majsterkowanieinietylko/EPROMINT/Documentation/CPU_architecture.png

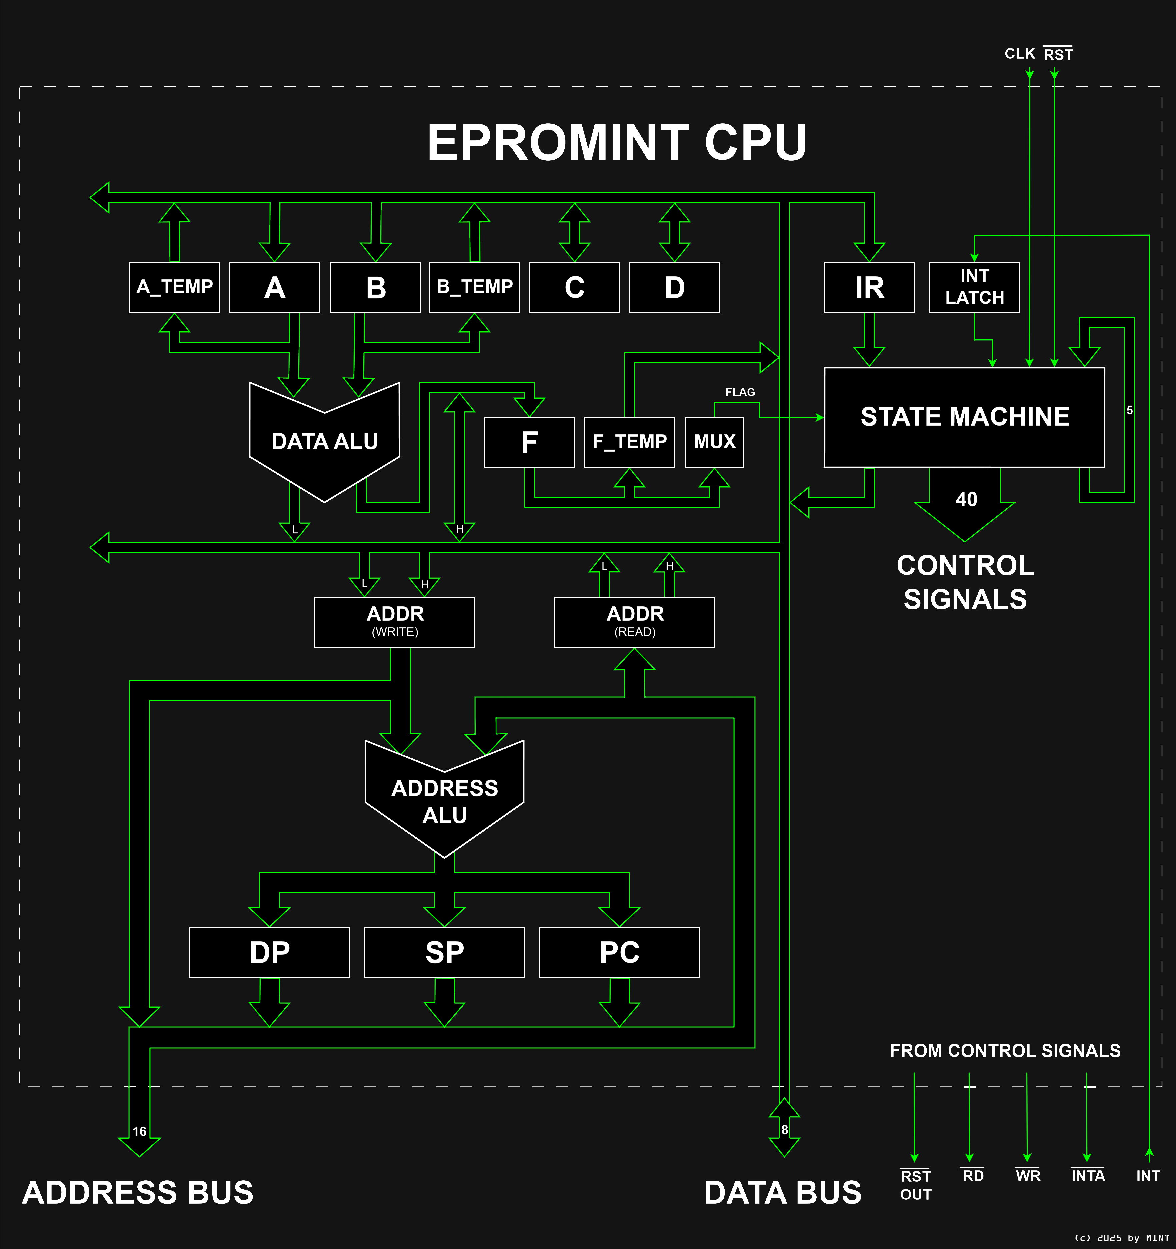
Documentation/CPU_architecture.png
