majsterkowanieinietylko/EPROMINT/Memory_Map_Generator/bg.png

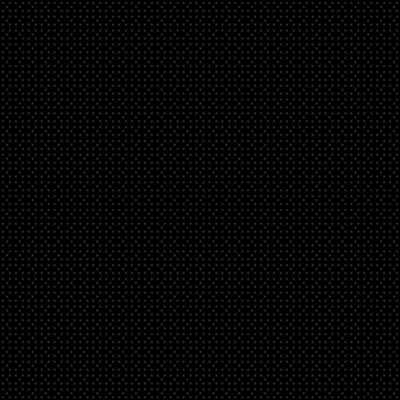
Memory_Map_Generator/bg.png
