majsterkowanieinietylko/EPROMINT/Memory_Map_Generator/ic.jpg

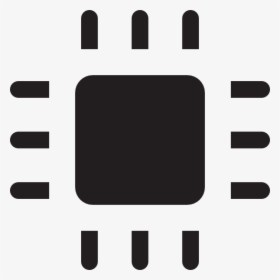
Memory_Map_Generator/ic.jpg
