majsterkowanieinietylko/EPROMINT/CPU_Programs/Bitmap_print/graphic_print.txt

41
EC 04 21
1A 09
19 0A
02
EC 0E 21
E8 20
EC 0F 21
E9 20
EC 08 21
1A 0B
19 0C
02
35
0D 00
0E 01
0F 00

EE 20
4B
D9 FB
50 01
A9 08
D7 F5

49
E6
