majsterkowanieinietylko/EPROMINT/Numeric_display/Schematic/Numeric_display.pdf

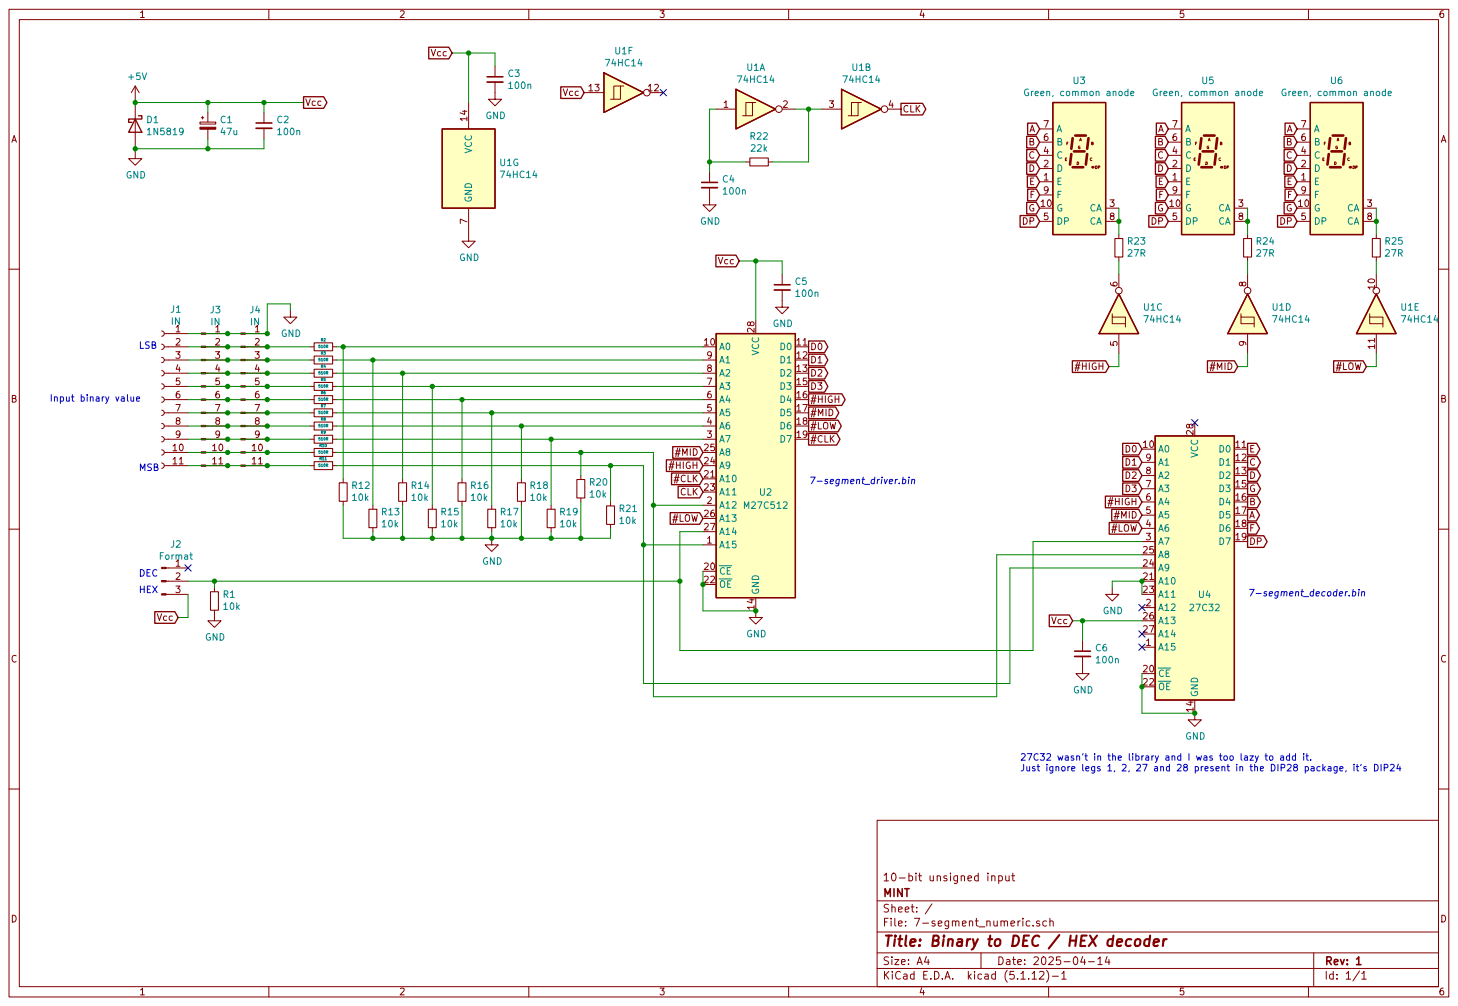
[picture p6: page 1]

27C32 wasn't in the library and I was too lazy to add it.
Just ignore legs 1, 2, 27 and 28 present in the DIP28 package, it's DIP24

10-bit unsigned input
File: 7-segment_numeric.sch Sheet: / MINT

Id: 1/1 Title: Binary to DEC / HEX decoder
