majsterkowanieinietylko/EPROMINT/Sequencer_board/Schematic/Sequencer_board.pdf

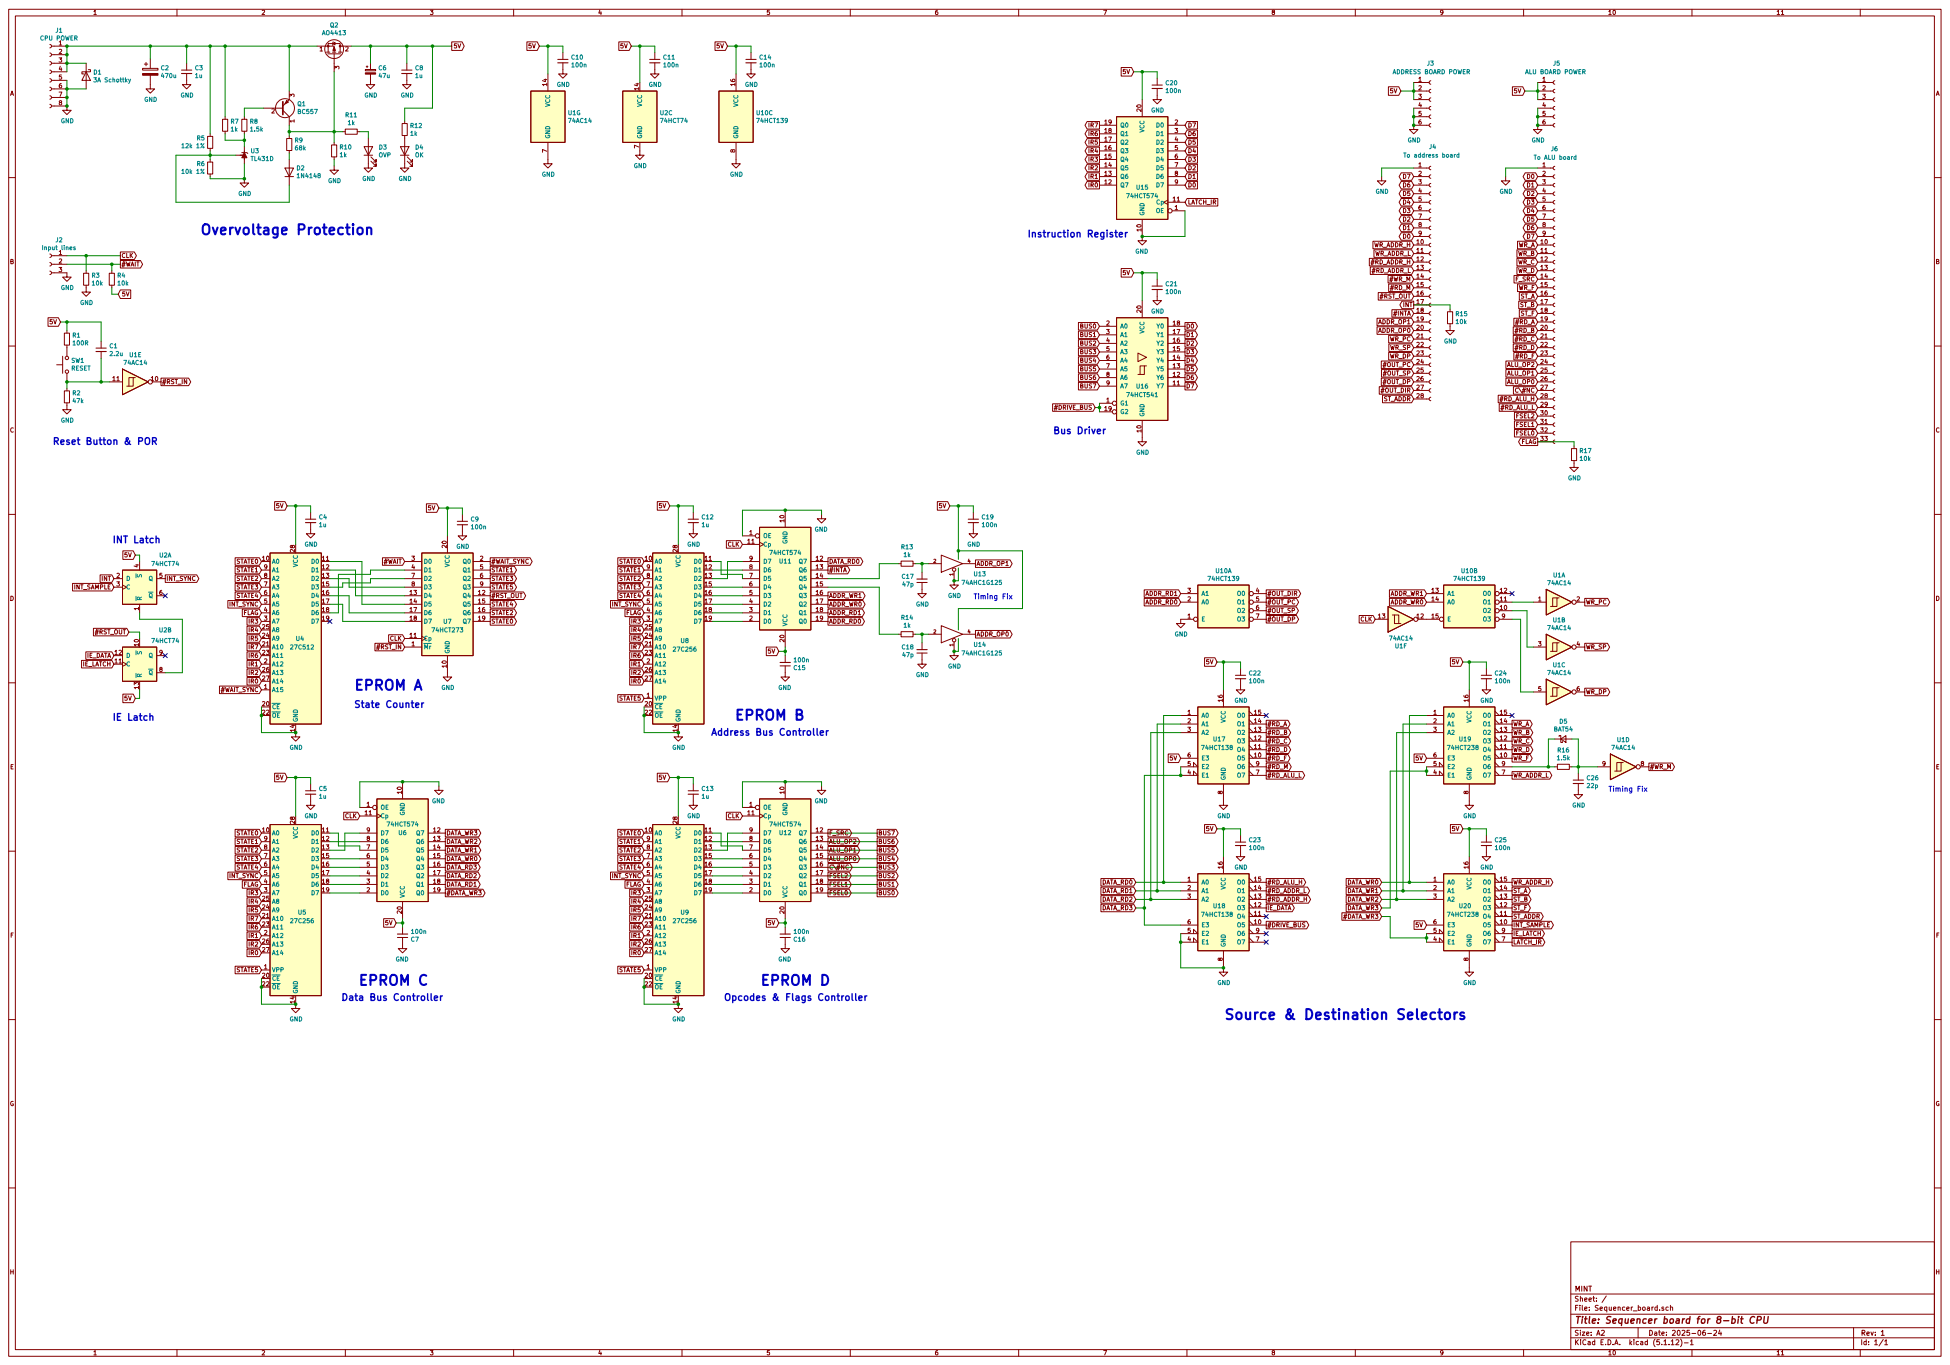
[picture p7: page 1]

J4 To address board VCC 14 GND

File: Sequencer_board.sch Sheet: / MINT

Id: 1/1 Title: Sequencer board for 8-bit CPU
