majsterkowanieinietylko/EPROMINT/ALU_board/Schematic/ALU_board.pdf

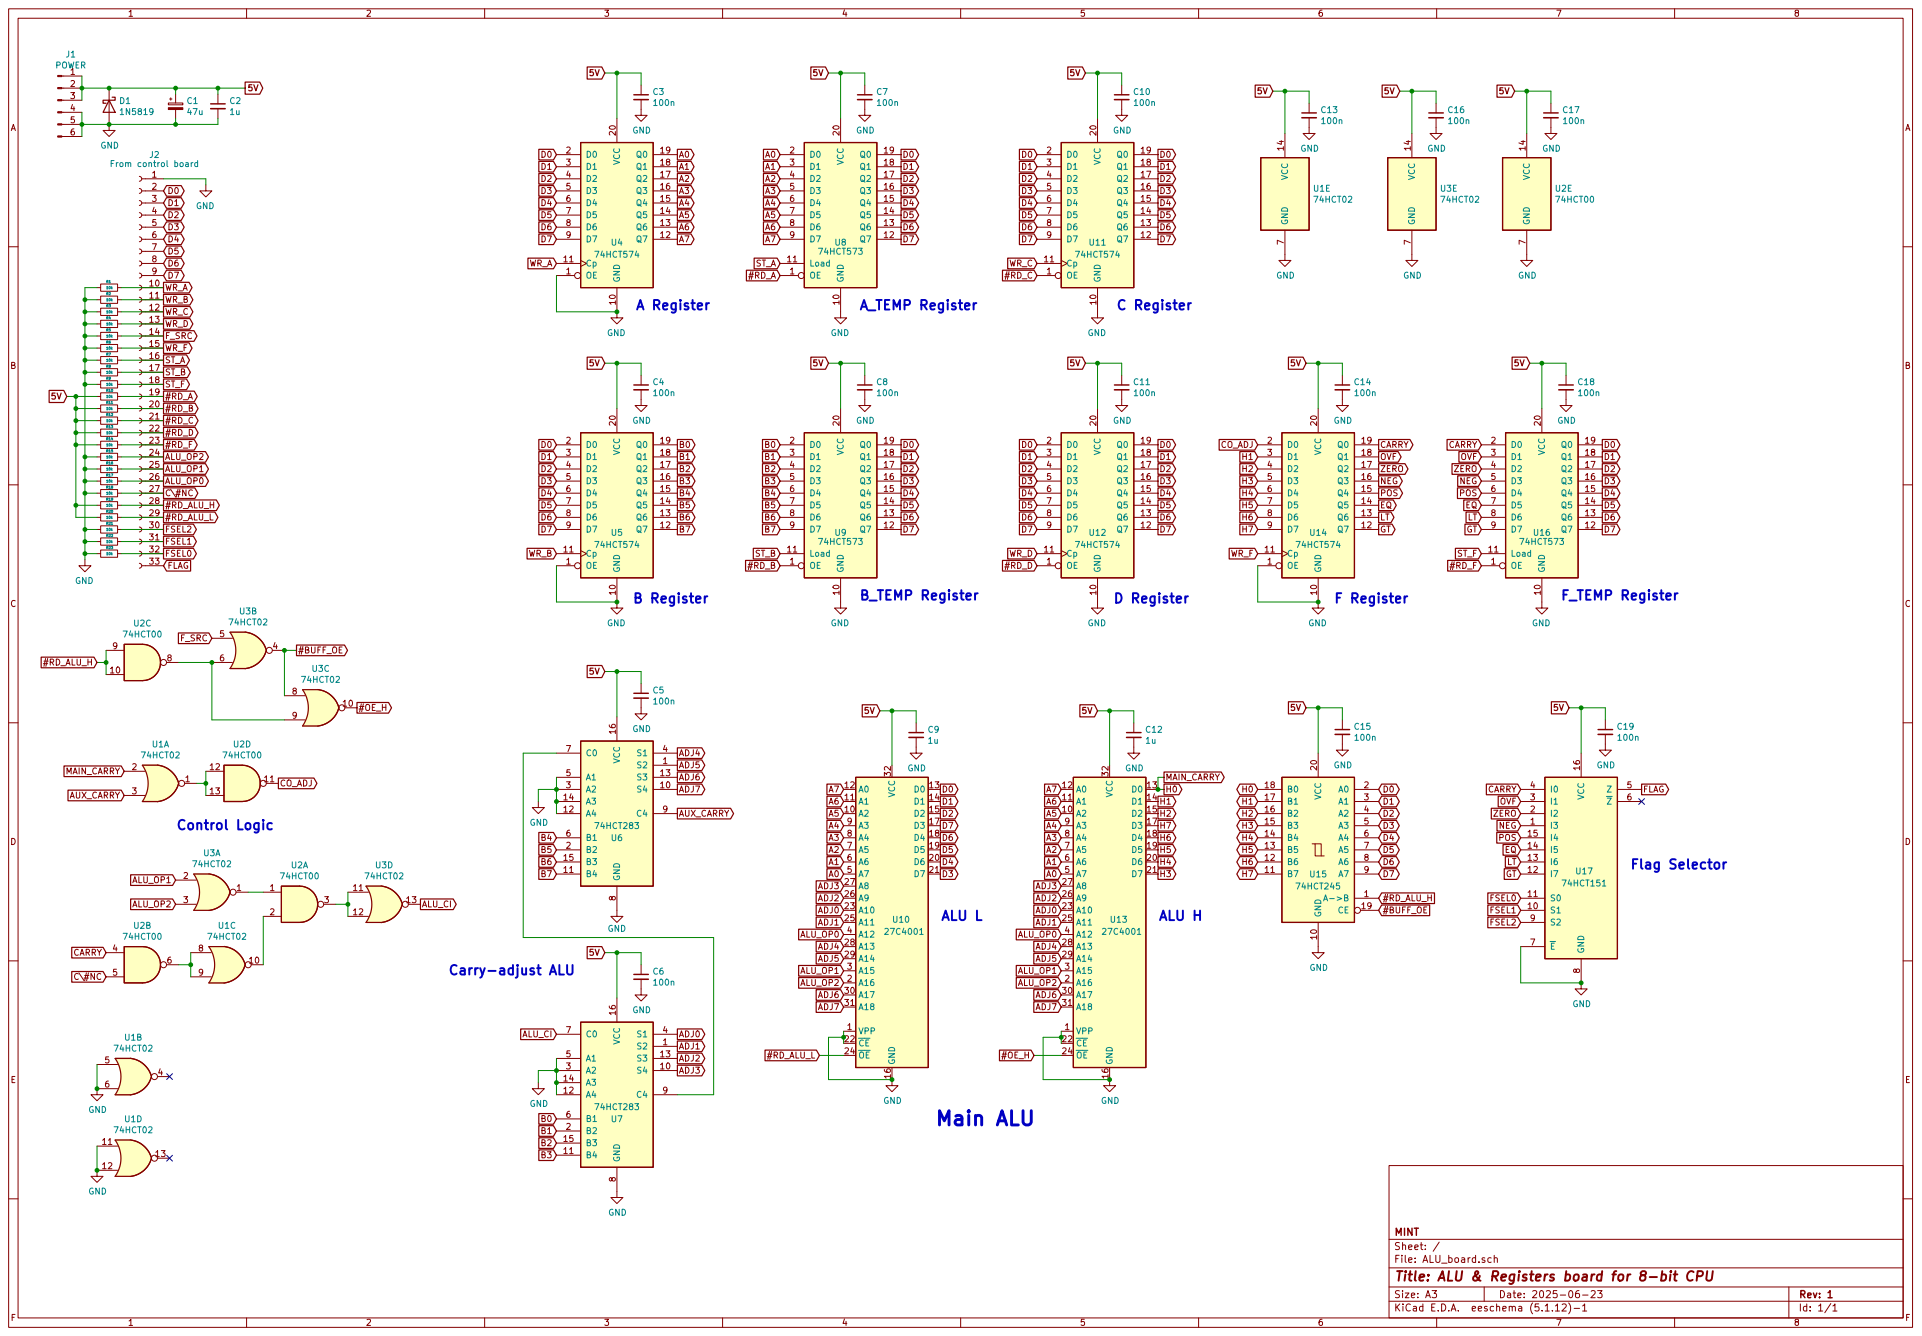
[picture p8: page 1]

File: ALU_board.sch Sheet: / MINT GND

Id: 1/1 Title: ALU & Registers board for 8-bit CPU
