majsterkowanieinietylko/EPROMINT/Documentation/EPROMINT_CPU_all.pdf

# GND GND

68k D2


J4 To address board VCC ¹⁴ GND

File: Sequencer_board.sch Sheet: / MINT

Id: 1/1 Title: Sequencer board for 8-bit CPU

# 100n GND OE 1 GND 10

# 74HCT573GND


File: ALU_board.sch Sheet: / MINT GND

Id: 1/1 Title: ALU & Registers board for 8-bit CPU

74HCT273 Mr 1 | GND 10
100n GND OE 1 | GND 10

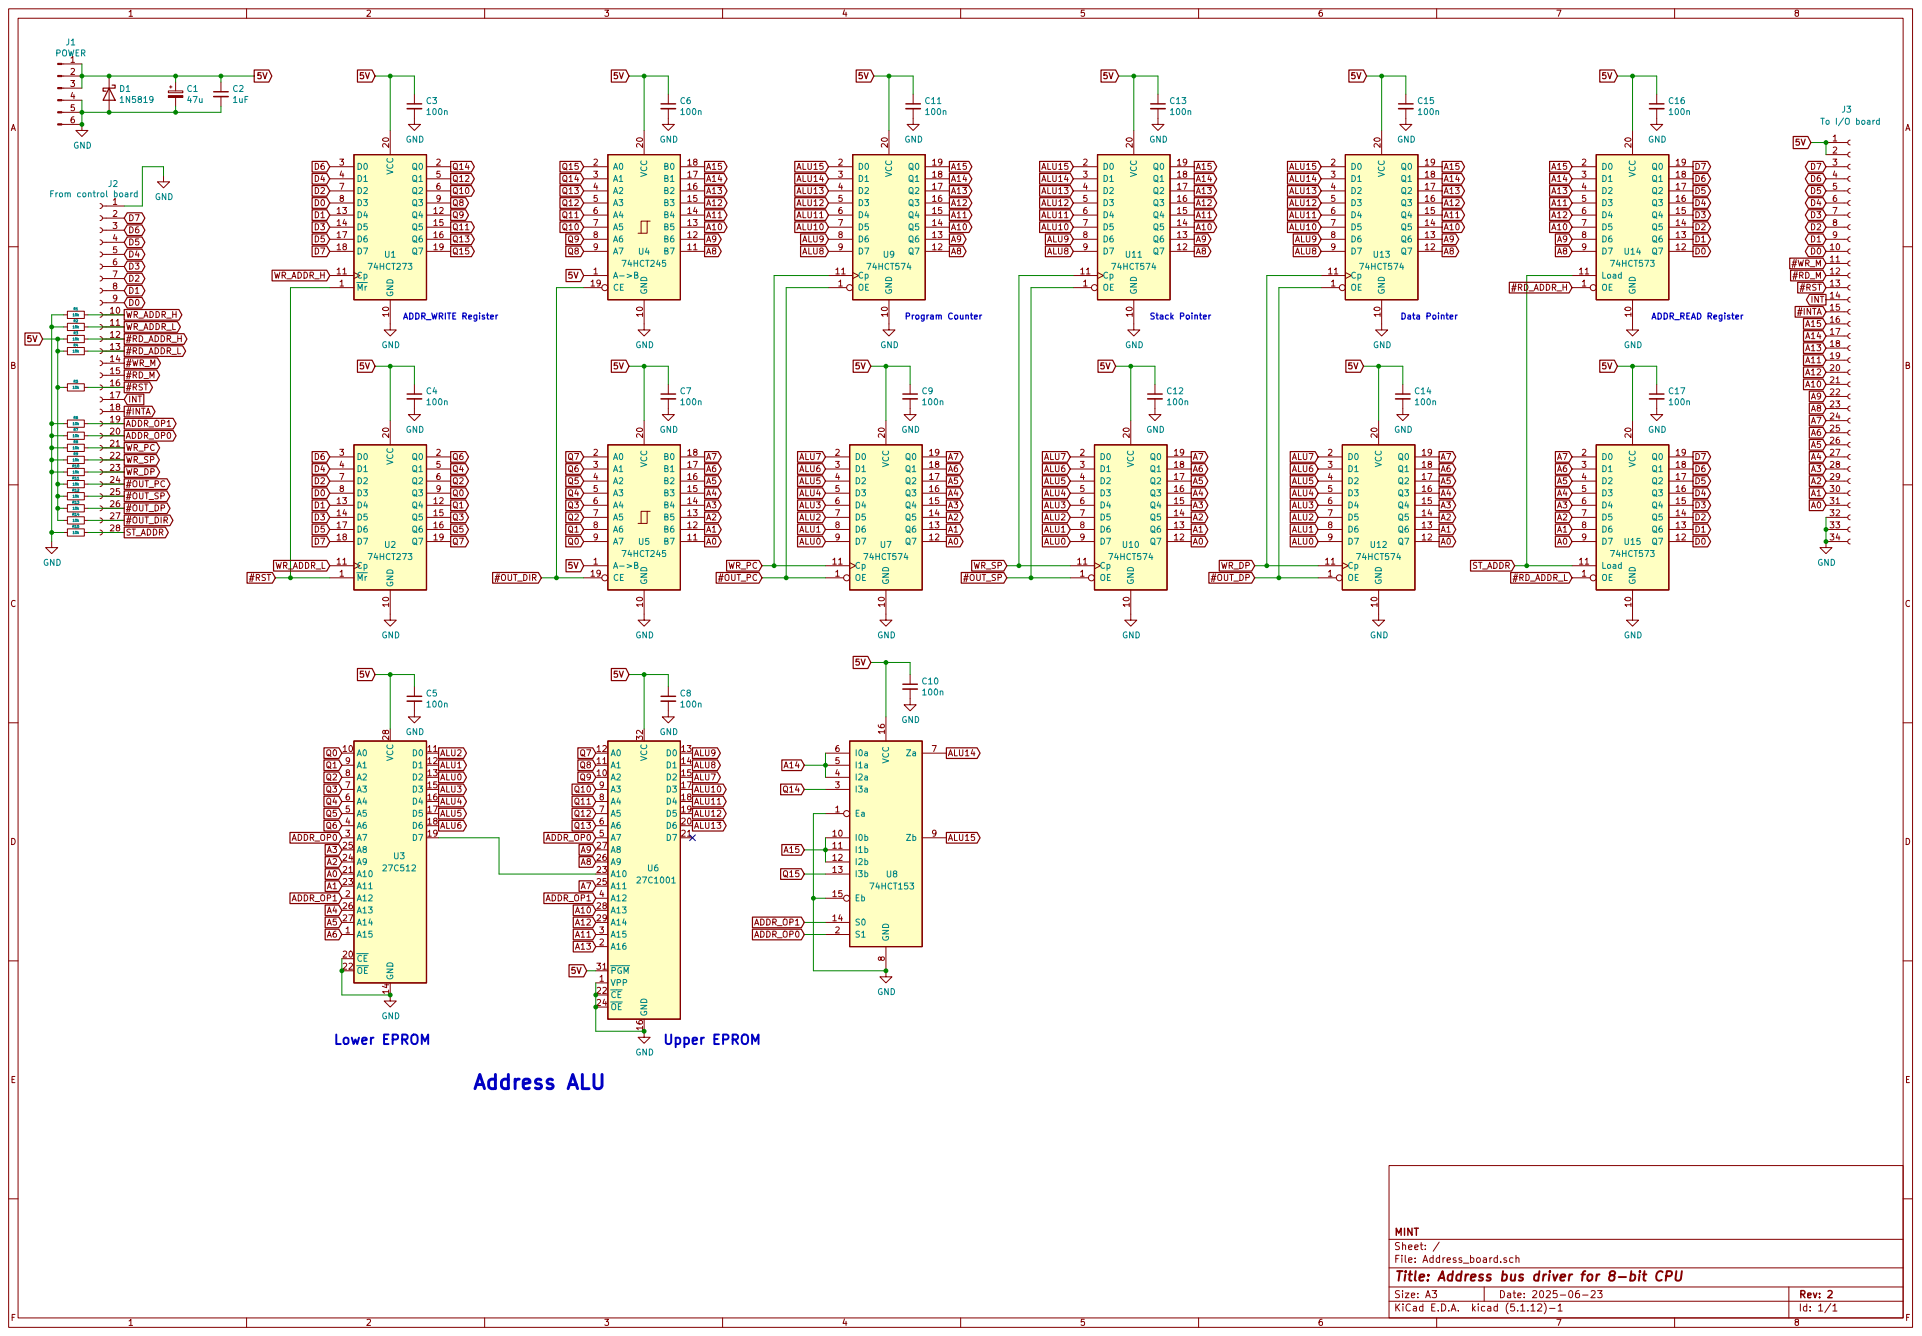
[picture p9: page 3]

Stack Pointer Address ALU

File: Address_board.sch Sheet: / MINT

Id: 1/1 Title: Address bus driver for 8-bit CPU

# 100n GNDVCC ¹⁴ GND

100n PA3 | 1 PC7 10 PC6 11 PC5 12 PC4 13 PC0 14 PC1 15 PC2 16 PC3 17 PB0 18 PB1 19 PA2 | 2 PB2 20 PB3 21 PB4 22 PB5 23 PB6 24 PB7 25 VCC ²⁶ D7 27 D6 28 D5 29 | PA1 | 3 D4 30 D3 31 D2 32 D1 33 D0 34 RESET 35 WR 36 | PA7 37 PA6 38 PA5 39 PA0 | 4 PA4 40 RD 5 CS 6 | GND

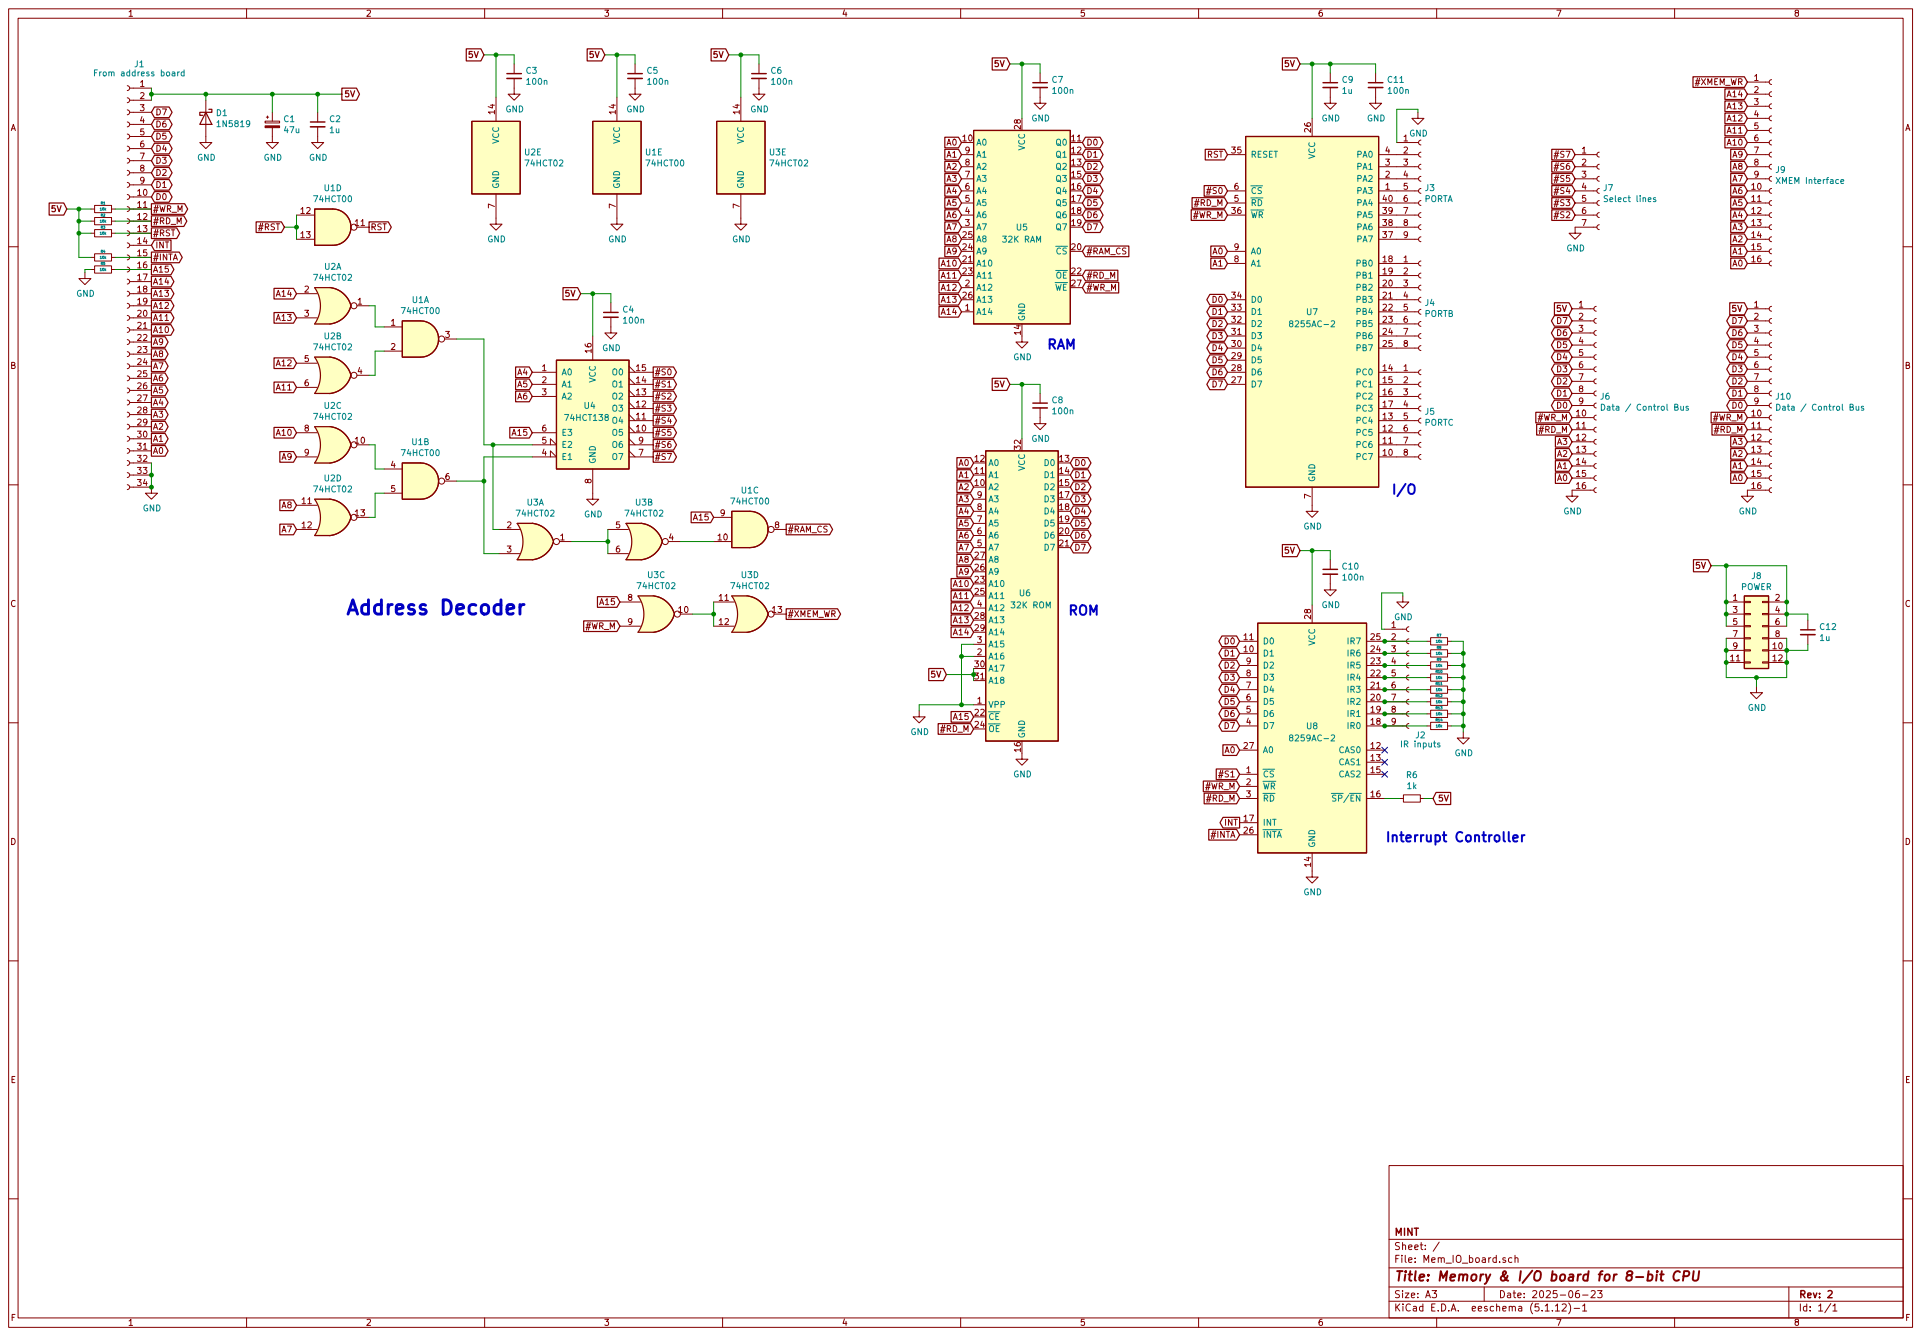
[picture p10: page 4]

GND GND VCC ¹⁴ GND

File: Mem_IO_board.sch Sheet: / MINT

Id: 1/1 Title: Memory & I/O board for 8-bit CPU
