majsterkowanieinietylko/EPROMINT/Memory_IO_board/Mem_IO_board.sch

## KiCad design Memory_IO_board/Mem_IO_board.sch (2025-07-03)

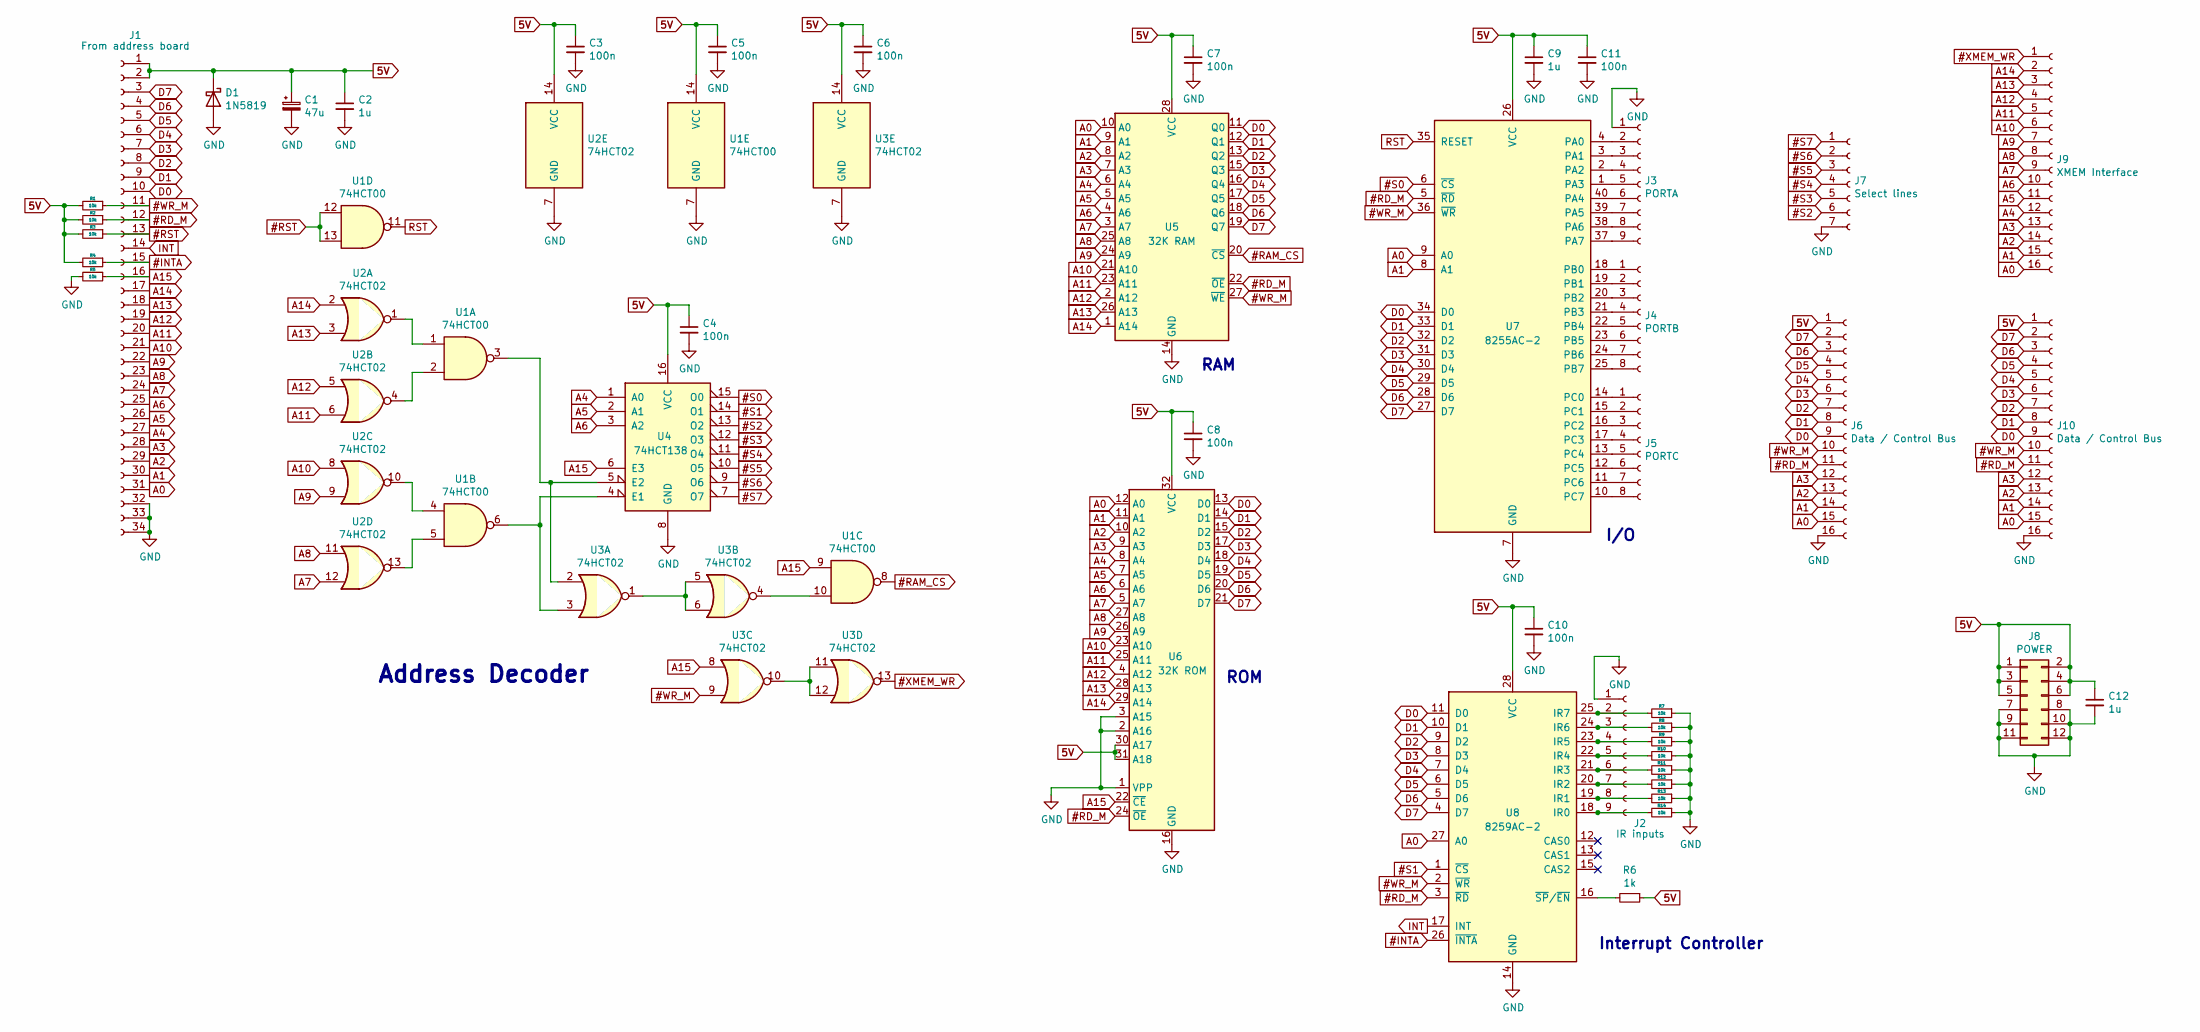
[picture p11: schematic Mem_IO_board.sch]

Parts:
C1: 47u
C2, C9, C12: 1u
C3, C4, C5, C6, C7, C8, C10, C11: 100n
D1: 1N5819; D_DO-41_SOD81_P10.16mm_Horizontal
J1: From address board
J2: IR inputs
J3: PORTA
J4: PORTB
J5: PORTC
J6, J10: Data / Control Bus
J7: Select lines
J8: POWER
J9: XMEM Interface
R1, R2, R3, R4, R5, R7, R8, R9, R10, R11, R12, R13, R14: 10k
R6: 1k
U1: 74HCT00
U2, U3: 74HCT02
U4: 74HCT138
U5: 32K RAM; DIP-28_W15.24mm
U6: 32K ROM
U7: 8255AC-2; DIP-40_W15.24mm
U8: 8259AC-2; DIP-28_W15.24mm

Connections:
5V: C1.1, C2.1, C3.1, C4.1, C5.1, C6.1, C7.1, C8.1, C9.1, C10.1, C11.1, C12.1, D1.1 (K), J1.1, J1.2, J6.1, J8.1, J8.2, J8.3, J8.4, J8.5, J8.6, J10.1, R1.2, R2.2, R3.2, R4.2, R6.1, U1.14 (VCC), U2.14 (VCC), U3.14 (VCC), U4.16 (VCC), U5.28 (VCC), U6.30 (A17), U6.31 (A18), U6.32 (VCC), U7.26 (VCC), U8.28 (VCC)
#INTA: J1.15, R4.1, U8.26 (~INTA~)
#RAM_CS: U1.8, U5.20 (~CS)
#RD_M: J1.12, J6.11, J10.11, R2.1, U5.22 (~OE), U6.24 (~OE), U7.5 (~RD~), U8.3 (~RD~)
#RST: J1.13, R3.1, U1.12, U1.13
#S0: U4.15 (O0), U7.6 (~CS~)
#S1: U4.14 (O1), U8.1 (~CS~)
#S2: J7.6, U4.13 (O2)
#S3: J7.5, U4.12 (O3)
#S4: J7.4, U4.11 (O4)
#S5: J7.3, U4.10 (O5)
#S6: J7.2, U4.9 (O6)
#S7: J7.1, U4.7 (O7)
#WR_M: J1.11, J6.10, J10.10, R1.1, U3.9, U5.27 (~WE), U7.36 (~WR~), U8.2 (~WR~)
#XMEM_WR: J9.1, U3.13
A0: J1.31, J6.15, J9.16, J10.15, U5.10 (A0), U6.12 (A0), U7.9 (A0), U8.27 (A0)
A1: J1.30, J6.14, J9.15, J10.14, U5.9 (A1), U6.11 (A1), U7.8 (A1)
A2: J1.29, J6.13, J9.14, J10.13, U5.8 (A2), U6.10 (A2)
A3: J1.28, J6.12, J9.13, J10.12, U5.7 (A3), U6.9 (A3)
A4: J1.27, J9.12, U4.1 (A0), U5.6 (A4), U6.8 (A4)
A5: J1.26, J9.11, U4.2 (A1), U5.5 (A5), U6.7 (A5)
A6: J1.25, J9.10, U4.3 (A2), U5.4 (A6), U6.6 (A6)
A7: J1.24, J9.9, U2.12, U5.3 (A7), U6.5 (A7)
A8: J1.23, J9.8, U2.11, U5.25 (A8), U6.27 (A8)
A9: J1.22, J9.7, U2.9, U5.24 (A9), U6.26 (A9)
A10: J1.21, J9.6, U2.8, U5.21 (A10), U6.23 (A10)
A11: J1.20, J9.5, U2.6, U5.23 (A11), U6.25 (A11)
A12: J1.19, J9.4, U2.5, U5.2 (A12), U6.4 (A12)
A13: J1.18, J9.3, U2.3, U5.26 (A13), U6.28 (A13)
A14: J1.17, J9.2, U2.2, U5.1 (A14), U6.29 (A14)
A15: J1.16, R5.1, U1.9, U3.8, U4.6 (E3), U6.22 (~CE)
D0: J1.10, J6.9, J10.9, U5.11 (Q0), U6.13 (D0), U7.34 (D0), U8.11 (D0)
D1: J1.9, J6.8, J10.8, U5.12 (Q1), U6.14 (D1), U7.33 (D1), U8.10 (D1)
D2: J1.8, J6.7, J10.7, U5.13 (Q2), U6.15 (D2), U7.32 (D2), U8.9 (D2)
D3: J1.7, J6.6, J10.6, U5.15 (Q3), U6.17 (D3), U7.31 (D3), U8.8 (D3)
D4: J1.6, J6.5, J10.5, U5.16 (Q4), U6.18 (D4), U7.30 (D4), U8.7 (D4)
D5: J1.5, J6.4, J10.4, U5.17 (Q5), U6.19 (D5), U7.29 (D5), U8.6 (D5)
D6: J1.4, J6.3, J10.3, U5.18 (Q6), U6.20 (D6), U7.28 (D6), U8.5 (D6)
D7: J1.3, J6.2, J10.2, U5.19 (Q7), U6.21 (D7), U7.27 (D7), U8.4 (D7)
GND: C1.2, C2.2, C3.2, C4.2, C5.2, C6.2, C7.2, C8.2, C9.2, C10.2, C11.2, C12.2, D1.2 (A), J1.32, J1.33, J1.34, J2.1, J3.1, J6.16, J7.7, J8.7, J8.8, J8.9, J8.10, J8.11, J8.12, J10.16, R5.2, R7.1, R8.1, R9.1, R10.1, R11.1, R12.1, R13.1, R14.1, U1.7 (GND), U2.7 (GND), U3.7 (GND), U4.8 (GND), U5.14 (GND), U6.1 (VPP), U6.2 (A16), U6.3 (A15), U6.16 (GND), U7.7 (GND), U8.14 (GND)
INT: J1.14, U8.17 (INT)
unnamed: J2.2, R7.2, U8.25 (IR7)
unnamed: J2.3, R8.2, U8.24 (IR6)
unnamed: J2.4, R9.2, U8.23 (IR5)
unnamed: J2.5, R10.2, U8.22 (IR4)
unnamed: J2.6, R11.2, U8.21 (IR3)
unnamed: J2.7, R12.2, U8.20 (IR2)
unnamed: J2.8, R13.2, U8.19 (IR1)
unnamed: J2.9, R14.2, U8.18 (IR0)
unnamed: J3.2, U7.4 (PA0)
unnamed: J3.3, U7.3 (PA1)
unnamed: J3.4, U7.2 (PA2)
unnamed: J3.5, U7.1 (PA3)
unnamed: J3.6, U7.40 (PA4)
unnamed: J3.7, U7.39 (PA5)
unnamed: J3.8, U7.38 (PA6)
unnamed: J3.9, U7.37 (PA7)
unnamed: J4.1, U7.18 (PB0)
unnamed: J4.2, U7.19 (PB1)
unnamed: J4.3, U7.20 (PB2)
unnamed: J4.4, U7.21 (PB3)
unnamed: J4.5, U7.22 (PB4)
unnamed: J4.6, U7.23 (PB5)
unnamed: J4.7, U7.24 (PB6)
unnamed: J4.8, U7.25 (PB7)
unnamed: J5.1, U7.14 (PC0)
unnamed: J5.2, U7.15 (PC1)
unnamed: J5.3, U7.16 (PC2)
unnamed: J5.4, U7.17 (PC3)
unnamed: J5.5, U7.13 (PC4)
unnamed: J5.6, U7.12 (PC5)
unnamed: J5.7, U7.11 (PC6)
unnamed: J5.8, U7.10 (PC7)
unnamed: R6.2, U8.16 (~SP~/~EN~)
unnamed: U1.1, U2.1
unnamed: U1.2, U2.4
unnamed: U1.3, U3.2, U4.5 (E2)
unnamed: U1.4, U2.10
unnamed: U1.5, U2.13
unnamed: U1.6, U3.3, U4.4 (E1)
unnamed: U1.10, U3.4
unnamed: U3.1, U3.5, U3.6
unnamed: U3.10, U3.11, U3.12
RST: U1.11, U7.35 (RESET)

Notes on the sheet:
Address Decoder
ROM
RAM
I/O
Interrupt Controller
