majsterkowanieinietylko/EPROMINT/ALU_board/Schematic/ALU_board.sch

## KiCad design ALU_board/Schematic/ALU_board.sch (2025-07-03)

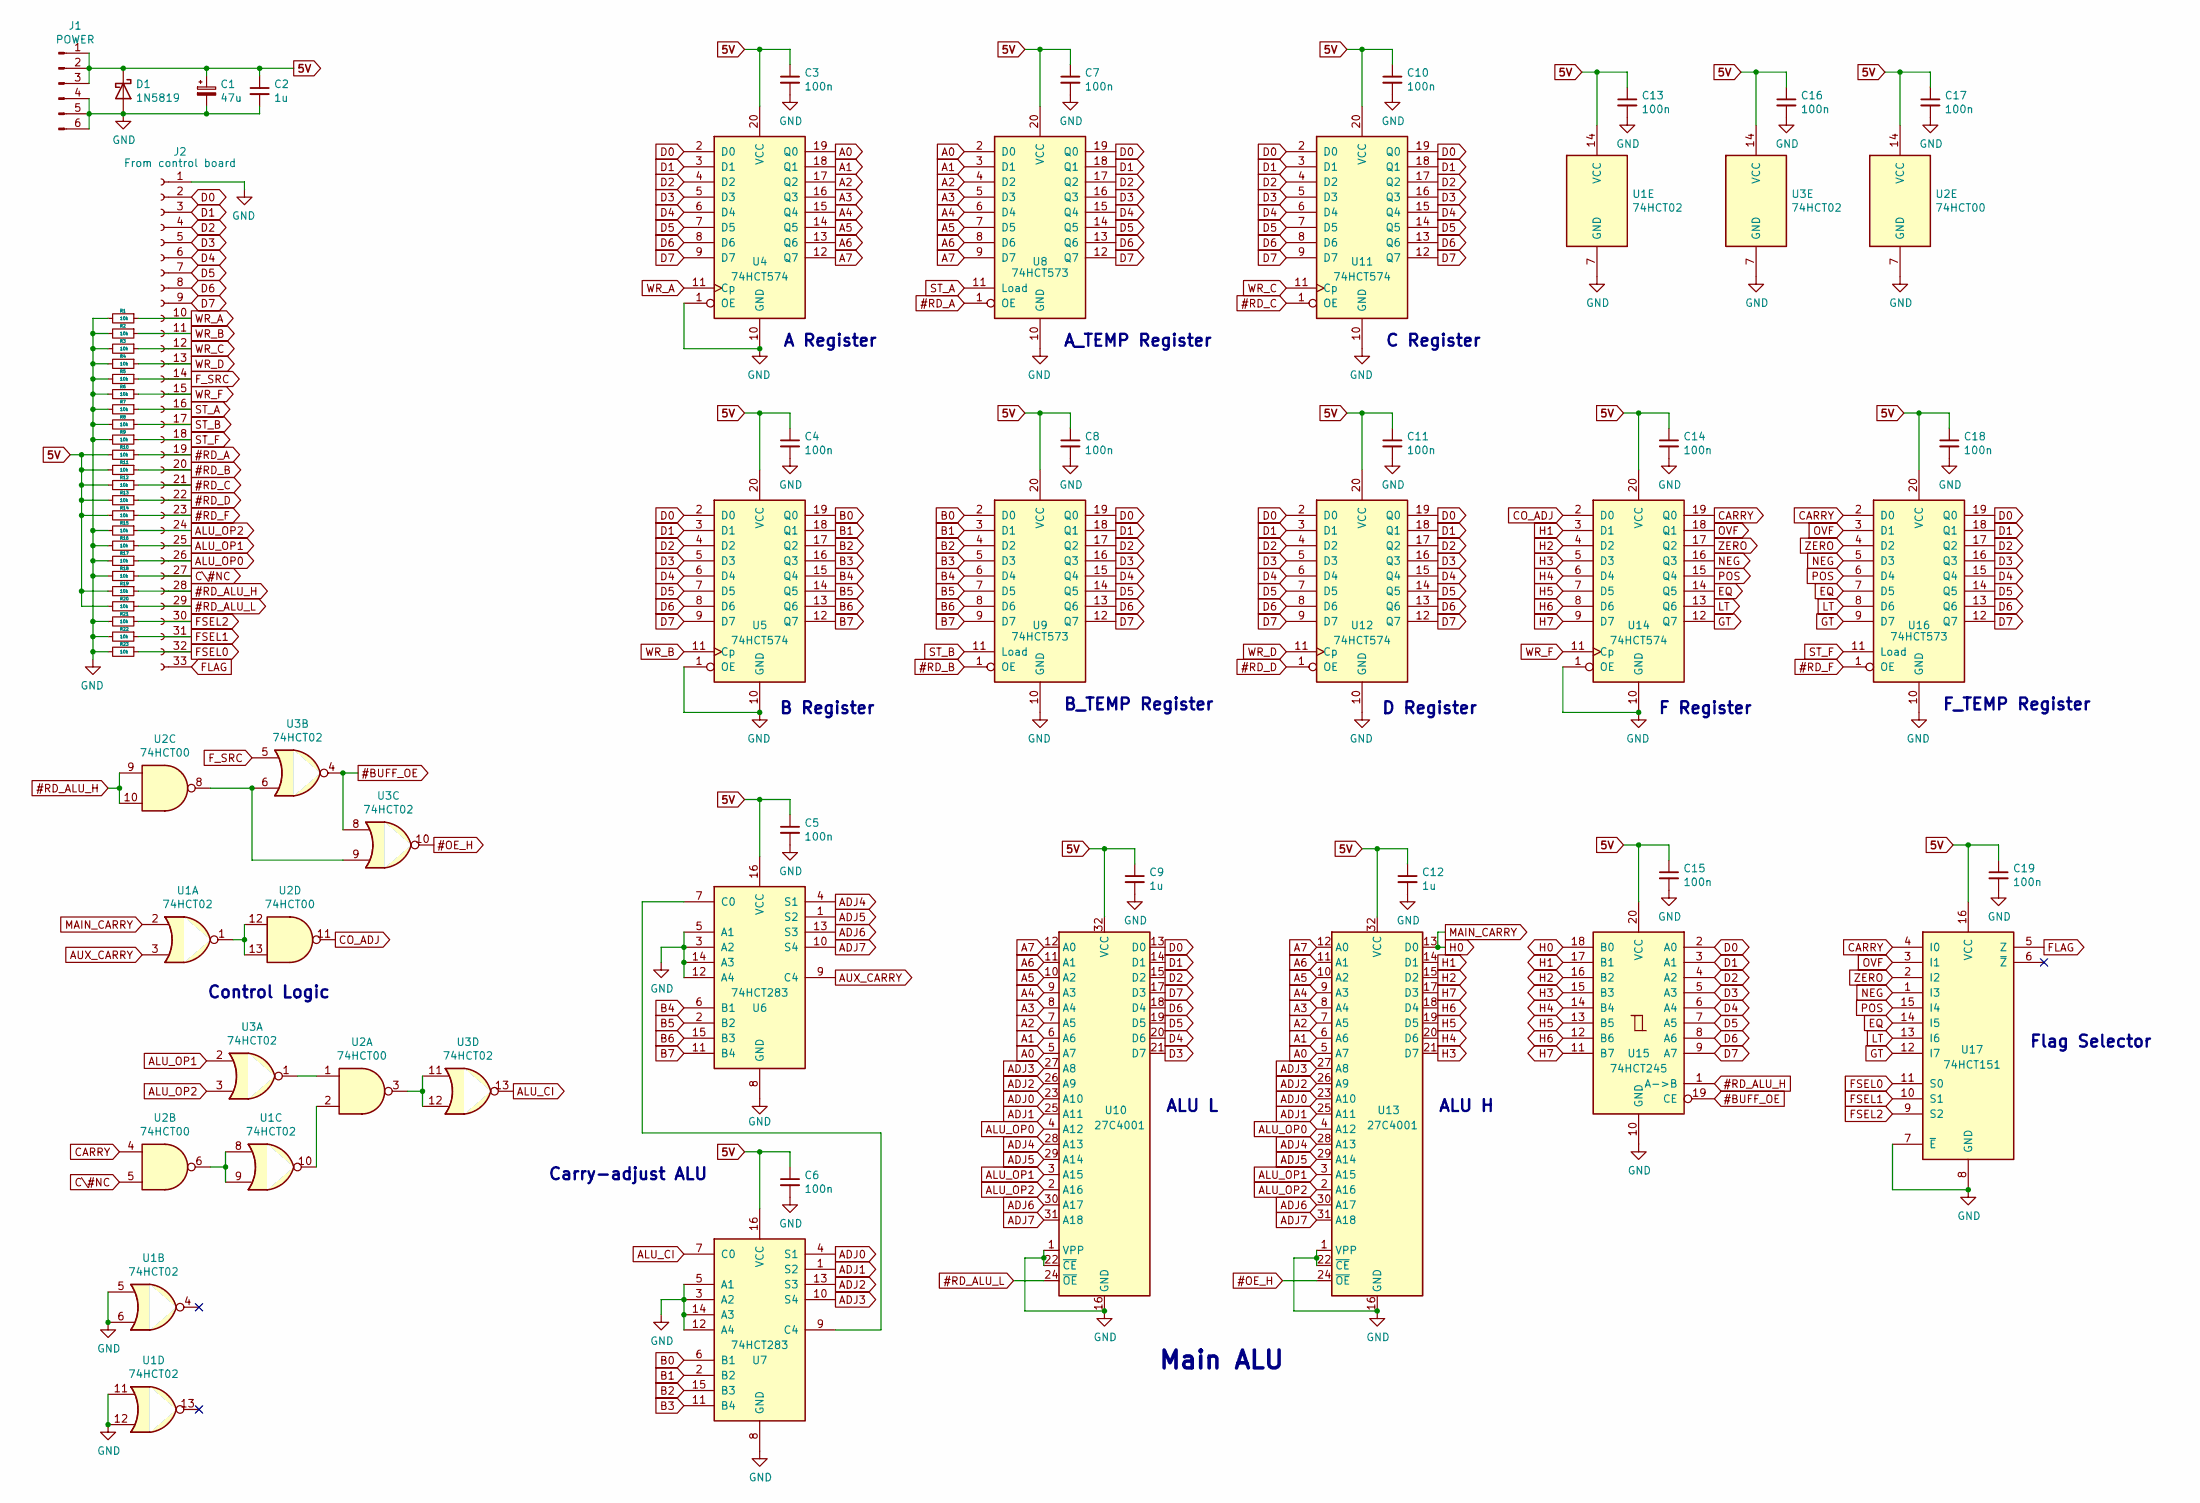
[picture p12: schematic ALU_board.sch]

Parts:
C1: 47u
C2, C9, C12: 1u
C3, C4, C5, C6, C7, C8, C10, C11, C13, C14, C15, C16, C17, C18, C19: 100n
D1: 1N5819; D_DO-41_SOD81_P10.16mm_Horizontal
J1: POWER
J2: From control board
R1, R2, R3, R4, R5, R6, R7, R8, R9, R10, R11, R12, R13, R14, R15, R16, R17, R18, R19, R20, R21, R22, R23: 10k
U1, U3: 74HCT02
U2: 74HCT00
U4, U5, U11, U12, U14: 74HCT574
U6, U7: 74HCT283
U8, U9, U16: 74HCT573
U10, U13: 27C4001
U15: 74HCT245
U17: 74HCT151

Connections:
5V: C1.1, C2.1, C3.1, C4.1, C5.1, C6.1, C7.1, C8.1, C9.1, C10.1, C11.1, C12.1, C13.1, C14.1, C15.1, C16.1, C17.1, C18.1, C19.1, D1.1 (K), J1.1, J1.2, J1.3, R10.2, R11.2, R12.2, R13.2, R14.2, R19.2, R20.2, U1.14 (VCC), U2.14 (VCC), U3.14 (VCC), U4.20 (VCC), U5.20 (VCC), U6.16 (VCC), U7.16 (VCC), U8.20 (VCC), U9.20 (VCC), U10.32 (VCC), U11.20 (VCC), U12.20 (VCC), U13.32 (VCC), U14.20 (VCC), U15.20 (VCC), U16.20 (VCC), U17.16 (VCC)
#BUFF_OE: U3.4, U3.8, U15.19 (CE)
#OE_H: U3.10, U13.24 (~OE)
#RD_A: J2.19, R10.1, U8.1 (OE)
#RD_ALU_H: J2.28, R19.1, U2.9, U2.10, U15.1 (A->B)
#RD_ALU_L: J2.29, R20.1, U10.24 (~OE)
#RD_B: J2.20, R11.1, U9.1 (OE)
#RD_C: J2.21, R12.1, U11.1 (OE)
#RD_D: J2.22, R13.1, U12.1 (OE)
#RD_F: J2.23, R14.1, U16.1 (OE)
A0: U4.19 (Q0), U8.2 (D0), U10.5 (A7), U13.5 (A7)
A1: U4.18 (Q1), U8.3 (D1), U10.6 (A6), U13.6 (A6)
A2: U4.17 (Q2), U8.4 (D2), U10.7 (A5), U13.7 (A5)
A3: U4.16 (Q3), U8.5 (D3), U10.8 (A4), U13.8 (A4)
A4: U4.15 (Q4), U8.6 (D4), U10.9 (A3), U13.9 (A3)
A5: U4.14 (Q5), U8.7 (D5), U10.10 (A2), U13.10 (A2)
A6: U4.13 (Q6), U8.8 (D6), U10.11 (A1), U13.11 (A1)
A7: U4.12 (Q7), U8.9 (D7), U10.12 (A0), U13.12 (A0)
ADJ0: U7.4 (S1), U10.23 (A10), U13.23 (A10)
ADJ1: U7.1 (S2), U10.25 (A11), U13.25 (A11)
ADJ2: U7.13 (S3), U10.26 (A9), U13.26 (A9)
ADJ3: U7.10 (S4), U10.27 (A8), U13.27 (A8)
ADJ4: U6.4 (S1), U10.28 (A13), U13.28 (A13)
ADJ5: U6.1 (S2), U10.29 (A14), U13.29 (A14)
ADJ6: U6.13 (S3), U10.30 (A17), U13.30 (A17)
ADJ7: U6.10 (S4), U10.31 (A18), U13.31 (A18)
ALU_CI: U3.13, U7.7 (C0)
ALU_OP0: J2.26, R17.1, U10.4 (A12), U13.4 (A12)
ALU_OP1: J2.25, R16.1, U3.2, U10.3 (A15), U13.3 (A15)
ALU_OP2: J2.24, R15.1, U3.3, U10.2 (A16), U13.2 (A16)
AUX_CARRY: U1.3, U6.9 (C4)
B0: U5.19 (Q0), U7.6 (B1), U9.2 (D0)
B1: U5.18 (Q1), U7.2 (B2), U9.3 (D1)
B2: U5.17 (Q2), U7.15 (B3), U9.4 (D2)
B3: U5.16 (Q3), U7.11 (B4), U9.5 (D3)
B4: U5.15 (Q4), U6.6 (B1), U9.6 (D4)
B5: U5.14 (Q5), U6.2 (B2), U9.7 (D5)
B6: U5.13 (Q6), U6.15 (B3), U9.8 (D6)
B7: U5.12 (Q7), U6.11 (B4), U9.9 (D7)
CARRY: U2.4, U14.19 (Q0), U16.2 (D0), U17.4 (I0)
CO_ADJ: U2.11, U14.2 (D0)
C\#NC: J2.27, R18.1, U2.5
D0: J2.2, U4.2 (D0), U5.2 (D0), U8.19 (Q0), U9.19 (Q0), U10.13 (D0), U11.2 (D0), U11.19 (Q0), U12.2 (D0), U12.19 (Q0), U15.2 (A0), U16.19 (Q0)
D1: J2.3, U4.3 (D1), U5.3 (D1), U8.18 (Q1), U9.18 (Q1), U10.14 (D1), U11.3 (D1), U11.18 (Q1), U12.3 (D1), U12.18 (Q1), U15.3 (A1), U16.18 (Q1)
D2: J2.4, U4.4 (D2), U5.4 (D2), U8.17 (Q2), U9.17 (Q2), U10.15 (D2), U11.4 (D2), U11.17 (Q2), U12.4 (D2), U12.17 (Q2), U15.4 (A2), U16.17 (Q2)
D3: J2.5, U4.5 (D3), U5.5 (D3), U8.16 (Q3), U9.16 (Q3), U10.21 (D7), U11.5 (D3), U11.16 (Q3), U12.5 (D3), U12.16 (Q3), U15.5 (A3), U16.16 (Q3)
D4: J2.6, U4.6 (D4), U5.6 (D4), U8.15 (Q4), U9.15 (Q4), U10.20 (D6), U11.6 (D4), U11.15 (Q4), U12.6 (D4), U12.15 (Q4), U15.6 (A4), U16.15 (Q4)
D5: J2.7, U4.7 (D5), U5.7 (D5), U8.14 (Q5), U9.14 (Q5), U10.19 (D5), U11.7 (D5), U11.14 (Q5), U12.7 (D5), U12.14 (Q5), U15.7 (A5), U16.14 (Q5)
D6: J2.8, U4.8 (D6), U5.8 (D6), U8.13 (Q6), U9.13 (Q6), U10.18 (D4), U11.8 (D6), U11.13 (Q6), U12.8 (D6), U12.13 (Q6), U15.8 (A6), U16.13 (Q6)
D7: J2.9, U4.9 (D7), U5.9 (D7), U8.12 (Q7), U9.12 (Q7), U10.17 (D3), U11.9 (D7), U11.12 (Q7), U12.9 (D7), U12.12 (Q7), U15.9 (A7), U16.12 (Q7)
EQ: U14.14 (Q5), U16.7 (D5), U17.14 (I5)
FLAG: J2.33, U17.5 (Z)
FSEL0: J2.32, R23.1, U17.11 (S0)
FSEL1: J2.31, R22.1, U17.10 (S1)
FSEL2: J2.30, R21.1, U17.9 (S2)
F_SRC: J2.14, R5.1, U3.5
GND: C1.2, C2.2, C3.2, C4.2, C5.2, C6.2, C7.2, C8.2, C9.2, C10.2, C11.2, C12.2, C13.2, C14.2, C15.2, C16.2, C17.2, C18.2, C19.2, D1.2 (A), J1.4, J1.5, J1.6, J2.1, R1.2, R2.2, R3.2, R4.2, R5.2, R6.2, R7.2, R8.2, R9.2, R15.2, R16.2, R17.2, R18.2, R21.2, R22.2, R23.2, U1.5, U1.6, U1.7 (GND), U1.11, U1.12, U2.7 (GND), U3.7 (GND), U4.1 (OE), U4.10 (GND), U5.1 (OE), U5.10 (GND), U6.3 (A2), U6.5 (A1), U6.8 (GND), U6.12 (A4), U6.14 (A3), U7.3 (A2), U7.5 (A1), U7.8 (GND), U7.12 (A4), U7.14 (A3), U8.10 (GND), U9.10 (GND), U10.1 (VPP), U10.16 (GND), U10.22 (~CE), U11.10 (GND), U12.10 (GND), U13.1 (VPP), U13.16 (GND), U13.22 (~CE), U14.1 (OE), U14.10 (GND), U15.10 (GND), U16.10 (GND), U17.7 (~E), U17.8 (GND)
GT: U14.12 (Q7), U16.9 (D7), U17.12 (I7)
H0: U1.2, U13.13 (D0), U15.18 (B0)
H1: U13.14 (D1), U14.3 (D1), U15.17 (B1)
H2: U13.15 (D2), U14.4 (D2), U15.16 (B2)
H3: U13.21 (D7), U14.5 (D3), U15.15 (B3)
H4: U13.20 (D6), U14.6 (D4), U15.14 (B4)
H5: U13.19 (D5), U14.7 (D5), U15.13 (B5)
H6: U13.18 (D4), U14.8 (D6), U15.12 (B6)
H7: U13.17 (D3), U14.9 (D7), U15.11 (B7)
LT: U14.13 (Q6), U16.8 (D6), U17.13 (I6)
NEG: U14.16 (Q3), U16.5 (D3), U17.1 (I3)
unnamed: U1.1, U2.12, U2.13
unnamed: U1.8, U1.9, U2.6
unnamed: U1.10, U2.2
unnamed: U2.1, U3.1
unnamed: U2.3, U3.11, U3.12
unnamed: U2.8, U3.6, U3.9
unnamed: U6.7 (C0), U7.9 (C4)
OVF: U14.18 (Q1), U16.3 (D1), U17.3 (I1)
POS: U14.15 (Q4), U16.6 (D4), U17.15 (I4)
ST_A: J2.16, R7.1, U8.11 (Load)
ST_B: J2.17, R8.1, U9.11 (Load)
ST_F: J2.18, R9.1, U16.11 (Load)
WR_A: J2.10, R1.1, U4.11 (Cp)
WR_B: J2.11, R2.1, U5.11 (Cp)
WR_C: J2.12, R3.1, U11.11 (Cp)
WR_D: J2.13, R4.1, U12.11 (Cp)
WR_F: J2.15, R6.1, U14.11 (Cp)
ZERO: U14.17 (Q2), U16.4 (D2), U17.2 (I2)

Notes on the sheet:
C Register
D Register
A Register
B Register
A_TEMP Register
B_TEMP Register
ALU L
Carry-adjust ALU
ALU H
F Register
F_TEMP Register
Control Logic
Flag Selector
Main ALU
