majsterkowanieinietylko/EPROMINT/Numeric_display/Schematic/7-segment_numeric.sch

## KiCad design Numeric_display/Schematic/7-segment_numeric.sch (2025-07-03)

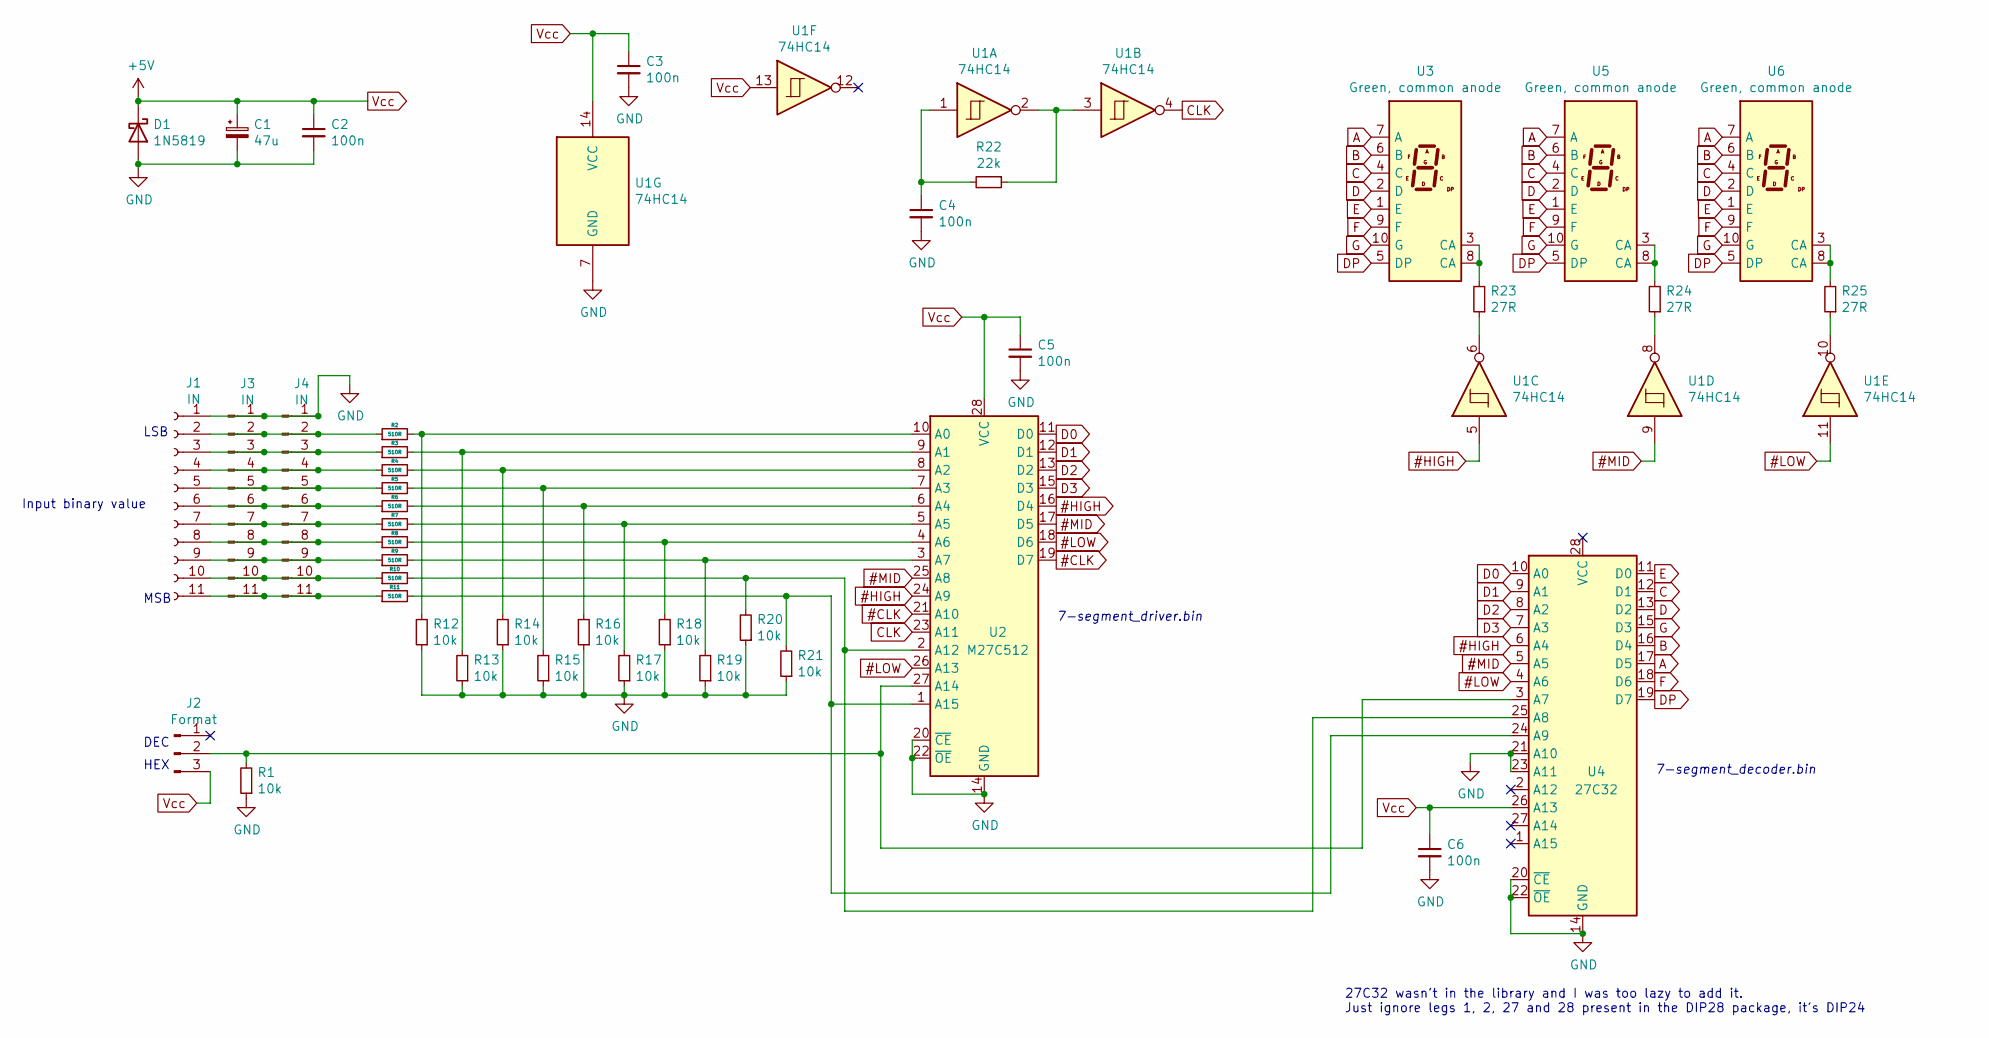
[picture p13: schematic 7-segment_numeric.sch]

Parts:
C1: 47u
C2, C3, C4, C5, C6: 100n
D1: 1N5819; D_DO-41_SOD81_P10.16mm_Horizontal
J1, J3, J4: IN
J2: Format
R1, R12, R13, R14, R15, R16, R17, R18, R19, R20, R21: 10k
R2, R3, R4, R5, R6, R7, R8, R9, R10, R11: 510R
R22: 22k
R23, R24, R25: 27R
U1: 74HC14
U2: M27C512; DIP-28_W15.24mm
U3, U5, U6: Green, common anode; KCSC02-123
U4: 27C32; DIP-28_W15.24mm

Connections:
#CLK: U2.19 (D7), U2.21 (A10)
#HIGH: U1.5, U2.16 (D4), U2.24 (A9), U4.6 (A4)
#LOW: U1.11, U2.18 (D6), U2.26 (A13), U4.4 (A6)
#MID: U1.9, U2.17 (D5), U2.25 (A8), U4.5 (A5)
+5V: C1.1, C2.1, C3.1, C5.1, C6.1, D1.1 (K), J2.3, U1.13, U1.14 (VCC), U2.28 (VCC), U4.26 (A13)
A: U3.7 (A), U4.17 (D5), U5.7 (A), U6.7 (A)
B: U3.6 (B), U4.16 (D4), U5.6 (B), U6.6 (B)
C: U3.4 (C), U4.12 (D1), U5.4 (C), U6.4 (C)
CLK: U1.4, U2.23 (A11)
D: U3.2 (D), U4.13 (D2), U5.2 (D), U6.2 (D)
D0: U2.11 (D0), U4.10 (A0)
D1: U2.12 (D1), U4.9 (A1)
D2: U2.13 (D2), U4.8 (A2)
D3: U2.15 (D3), U4.7 (A3)
DP: U3.5 (DP), U4.19 (D7), U5.5 (DP), U6.5 (DP)
E: U3.1 (E), U4.11 (D0), U5.1 (E), U6.1 (E)
F: U3.9 (F), U4.18 (D6), U5.9 (F), U6.9 (F)
G: U3.10 (G), U4.15 (D3), U5.10 (G), U6.10 (G)
GND: C1.2, C2.2, C3.2, C4.2, C5.2, C6.2, D1.2 (A), J1.1, J3.1, J4.1, R1.1, R12.1, R13.1, R14.1, R15.1, R16.1, R17.1, R18.1, R19.1, R20.1, R21.1, U1.7 (GND), U2.14 (GND), U2.20 (~CE), U2.22 (~OE), U4.14 (GND), U4.20 (~CE), U4.21 (A10), U4.22 (~OE), U4.23 (A11)
unnamed: C4.1, R22.2, U1.1
unnamed: J1.2, J3.2, J4.2, R2.1
unnamed: J1.3, J3.3, J4.3, R3.1
unnamed: J1.4, J3.4, J4.4, R4.1
unnamed: J1.5, J3.5, J4.5, R5.1
unnamed: J1.6, J3.6, J4.6, R6.1
unnamed: J1.7, J3.7, J4.7, R7.1
unnamed: J1.8, J3.8, J4.8, R8.1
unnamed: J1.9, J3.9, J4.9, R9.1
unnamed: J1.10, J3.10, J4.10, R10.1
unnamed: J1.11, J3.11, J4.11, R11.1
unnamed: J2.2, R1.2, U2.27 (A14), U4.3 (A7)
unnamed: R10.2, R20.2, U2.2 (A12), U4.25 (A8)
unnamed: R11.2, R21.2, U2.1 (A15), U4.24 (A9)
unnamed: R2.2, R12.2, U2.10 (A0)
unnamed: R3.2, R13.2, U2.9 (A1)
unnamed: R4.2, R14.2, U2.8 (A2)
unnamed: R5.2, R15.2, U2.7 (A3)
unnamed: R6.2, R16.2, U2.6 (A4)
unnamed: R7.2, R17.2, U2.5 (A5)
unnamed: R8.2, R18.2, U2.4 (A6)
unnamed: R9.2, R19.2, U2.3 (A7)
unnamed: R22.1, U1.2, U1.3
unnamed: R23.1, U1.6
unnamed: R23.2, U3.3 (CA), U3.8 (CA)
unnamed: R24.1, U1.8
unnamed: R24.2, U5.3 (CA), U5.8 (CA)
unnamed: R25.1, U1.10
unnamed: R25.2, U6.3 (CA), U6.8 (CA)

Notes on the sheet:
Input binary value
LSB
MSB
DEC
HEX
27C32 wasn't in the library and I was too lazy to add it. Just ignore legs 1, 2, 27 and 28 present in the DIP28 package, it's DIP24
7-segment_driver.bin
7-segment_decoder.bin
