majsterkowanieinietylko/EPROMINT/Sequencer_board/Schematic/Sequencer_board.sch

## KiCad design Sequencer_board/Schematic/Sequencer_board.sch (2025-07-03)

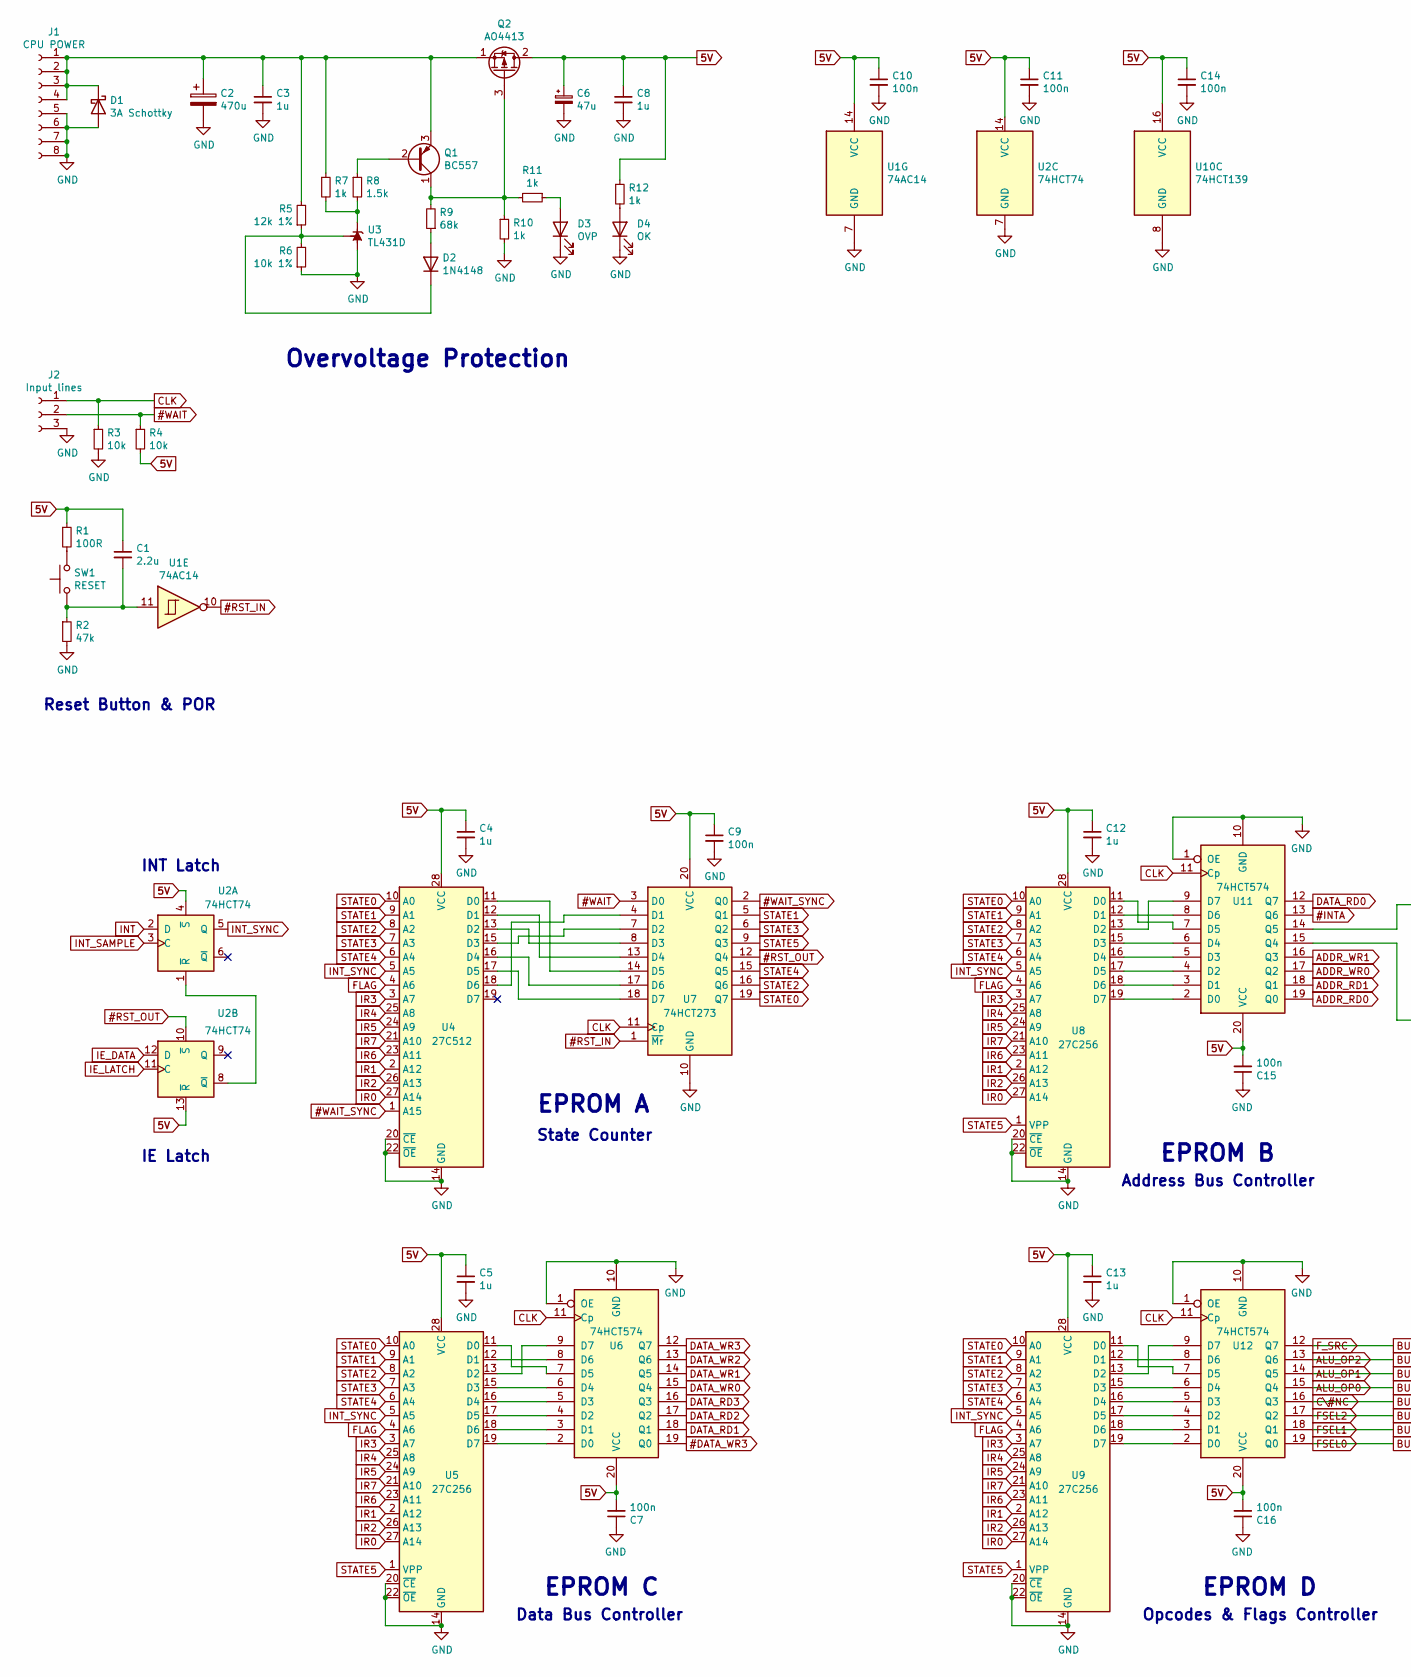
[picture p14: schematic Sequencer_board.sch, part in row 1, column 1]

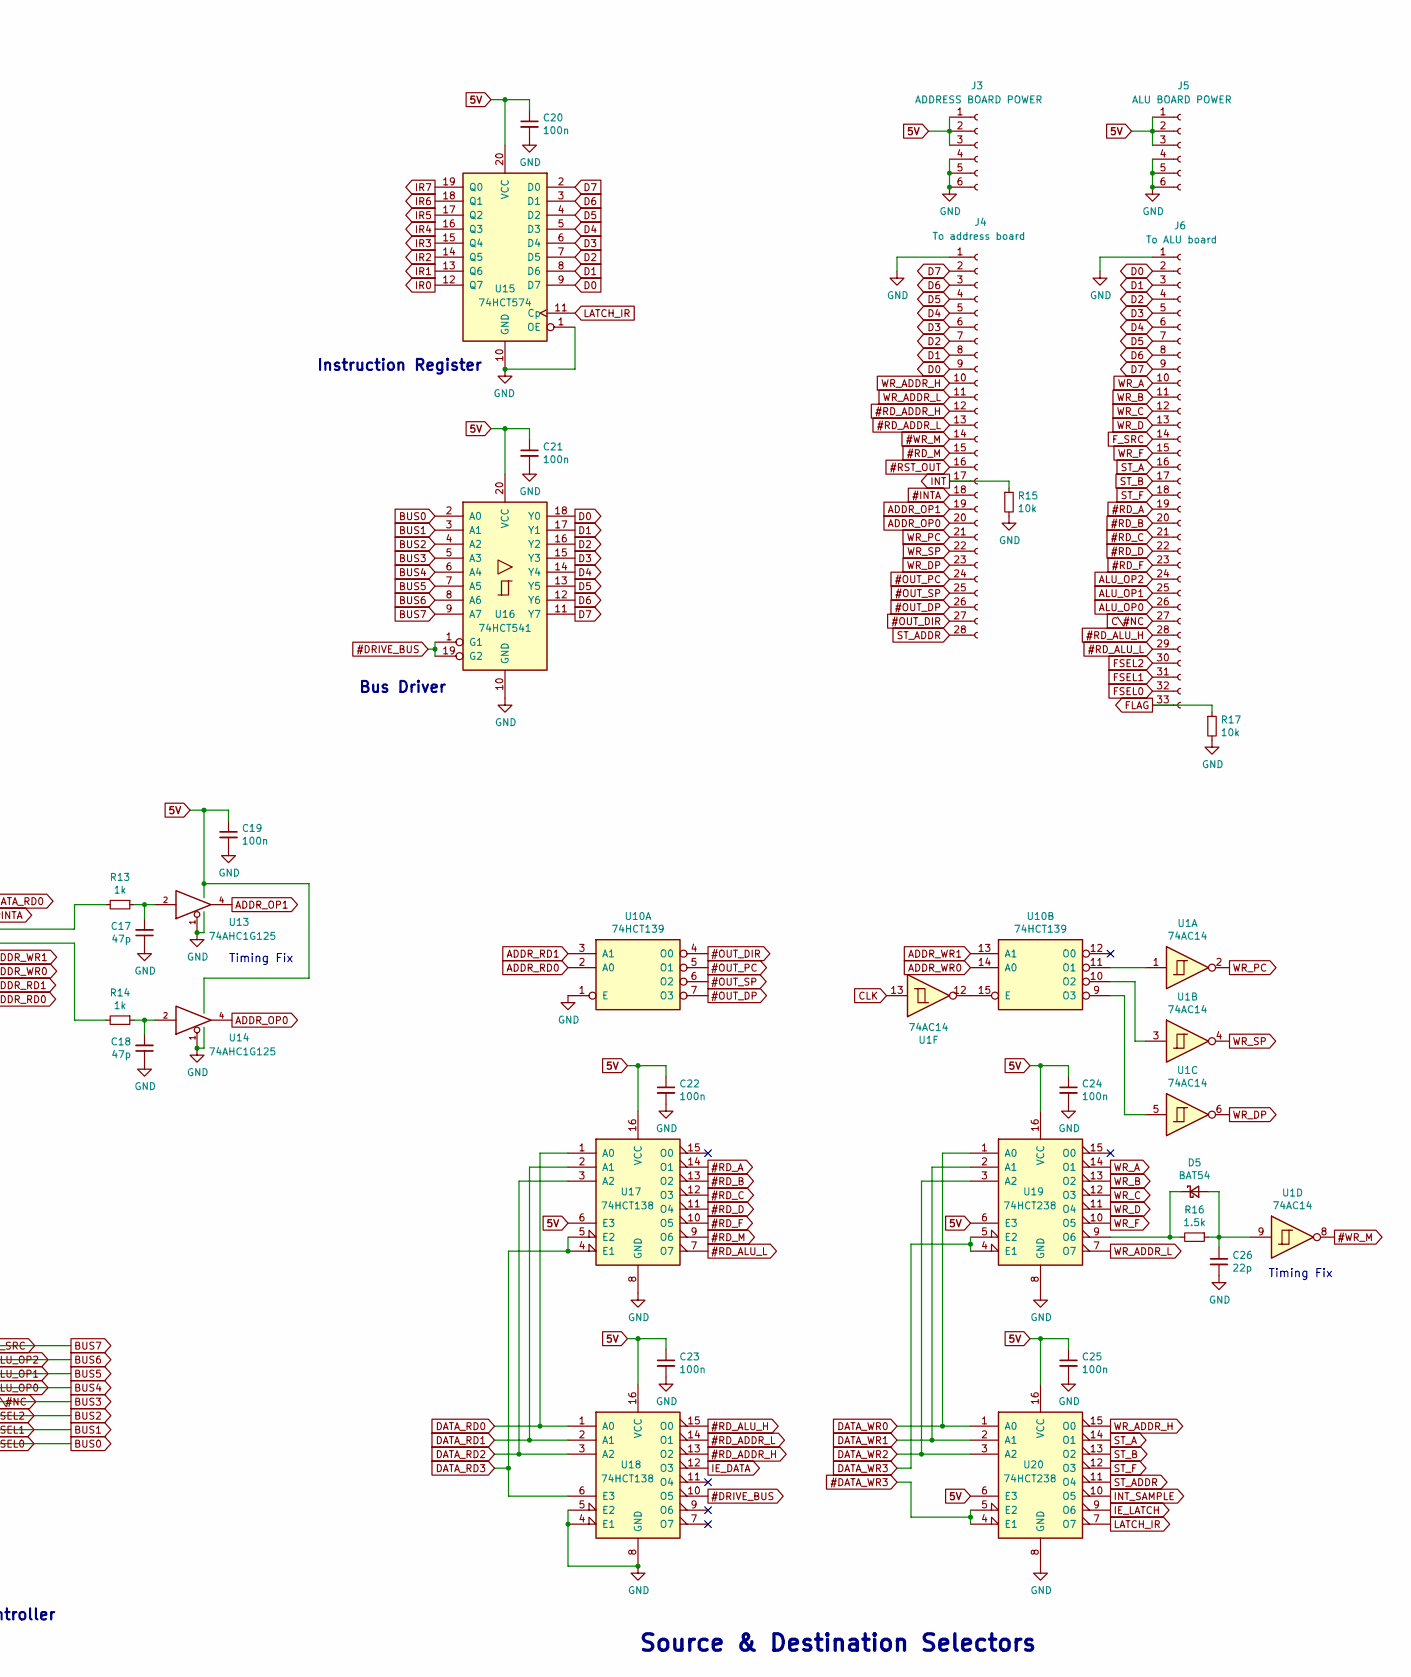
[picture p15: schematic Sequencer_board.sch, part in row 1, column 2]

Parts:
C1: 2.2u
C2: 470u
C3, C4, C5, C8, C12, C13: 1u
C6: 47u
C7, C9, C10, C11, C14, C15, C16, C19, C20, C21, C22, C23, C24, C25: 100n
C17, C18: 47p
C26: 22p
D1: 3A Schottky
D2: 1N4148; D_DO-35_SOD27_P7.62mm_Horizontal
D3: OVP
D4: OK
D5: BAT54
J1: CPU POWER
J2: Input lines
J3: ADDRESS BOARD POWER
J4: To address board
J5: ALU BOARD POWER
J6: To ALU board
Q1: BC557; TO-92_Inline
Q2: AO4413
R1: 100R
R2: 47k
R3, R4, R15, R17: 10k
R5: 12k 1%
R6: 10k 1%
R7, R10, R11, R12, R13, R14: 1k
R8, R16: 1.5k
R9: 68k
SW1: RESET
U1: 74AC14
U2: 74HCT74
U3: TL431D; SOIC-8_3.9x4.9mm_P1.27mm
U4: 27C512; DIP-28_W15.24mm
U5, U8, U9: 27C256; DIP-28_W15.24mm
U6, U11, U12, U15: 74HCT574
U7: 74HCT273
U10: 74HCT139
U13, U14: 74AHC1G125
U16: 74HCT541
U17, U18: 74HCT138
U19, U20: 74HCT238

Connections:
5V: C1.1, C4.1, C5.1, C6.1, C7.2, C8.1, C9.1, C10.1, C11.1, C12.1, C13.1, C14.1, C15.2, C16.2, C19.1, C20.1, C21.1, C22.1, C23.1, C24.1, C25.1, J3.1, J3.2, J3.3, J5.1, J5.2, J5.3, Q2.2 (D), R1.1, R4.2, R12.1, U1.14 (VCC), U2.4 (~S), U2.13 (~R), U2.14 (VCC), U4.28 (VCC), U5.28 (VCC), U6.20 (VCC), U7.20 (VCC), U8.28 (VCC), U9.28 (VCC), U10.16 (VCC), U11.20 (VCC), U12.20 (VCC), U13.3 (GND), U14.3 (GND), U15.20 (VCC), U16.20 (VCC), U17.6 (E3), U17.16 (VCC), U18.16 (VCC), U19.6 (E3), U19.16 (VCC), U20.6 (E3), U20.16 (VCC)
#DATA_WR3: U6.19 (Q0), U20.4 (E1), U20.5 (E2)
#DRIVE_BUS: U16.1 (G1), U16.19 (G2), U18.10 (O5)
#INTA: J4.18, U11.13 (Q6)
#OUT_DIR: J4.27, U10.4 (O0)
#OUT_DP: J4.26, U10.7 (O3)
#OUT_PC: J4.24, U10.5 (O1)
#OUT_SP: J4.25, U10.6 (O2)
#RD_A: J6.19, U17.14 (O1)
#RD_ADDR_H: J4.12, U18.13 (O2)
#RD_ADDR_L: J4.13, U18.14 (O1)
#RD_ALU_H: J6.28, U18.15 (O0)
#RD_ALU_L: J6.29, U17.7 (O7)
#RD_B: J6.20, U17.13 (O2)
#RD_C: J6.21, U17.12 (O3)
#RD_D: J6.22, U17.11 (O4)
#RD_F: J6.23, U17.10 (O5)
#RD_M: J4.15, U17.9 (O6)
#RST_IN: U1.10, U7.1 (~Mr)
#RST_OUT: J4.16, U2.10 (~S), U7.12 (Q4)
#WAIT: J2.2, R4.1, U7.3 (D0)
#WAIT_SYNC: U4.1 (A15), U7.2 (Q0)
#WR_M: J4.14, U1.8
ADDR_OP0: J4.20, U14.4
ADDR_OP1: J4.19, U13.4
ADDR_RD0: U10.2 (A0), U11.19 (Q0)
ADDR_RD1: U10.3 (A1), U11.18 (Q1)
ADDR_WR0: U10.14 (A0), U11.17 (Q2)
ADDR_WR1: U10.13 (A1), U11.16 (Q3)
ALU_OP0: J6.26, U12.15 (Q4), U16.6 (A4)
ALU_OP1: J6.25, U12.14 (Q5), U16.7 (A5)
ALU_OP2: J6.24, U12.13 (Q6), U16.8 (A6)
BUS0: J6.32, U12.19 (Q0), U16.2 (A0)
BUS1: J6.31, U12.18 (Q1), U16.3 (A1)
BUS2: J6.30, U12.17 (Q2), U16.4 (A2)
BUS3: J6.27, U12.16 (Q3), U16.5 (A3)
BUS7: J6.14, U12.12 (Q7), U16.9 (A7)
CLK: J2.1, R3.1, U1.13, U6.11 (Cp), U7.11 (Cp), U11.11 (Cp), U12.11 (Cp)
D0: J4.9, J6.2, U15.9 (D7), U16.18 (Y0)
D1: J4.8, J6.3, U15.8 (D6), U16.17 (Y1)
D2: J4.7, J6.4, U15.7 (D5), U16.16 (Y2)
D3: J4.6, J6.5, U15.6 (D4), U16.15 (Y3)
D4: J4.5, J6.6, U15.5 (D3), U16.14 (Y4)
D5: J4.4, J6.7, U15.4 (D2), U16.13 (Y5)
D6: J4.3, J6.8, U15.3 (D1), U16.12 (Y6)
D7: J4.2, J6.9, U15.2 (D0), U16.11 (Y7)
DATA_RD0: U11.12 (Q7), U17.1 (A0), U18.1 (A0)
DATA_RD1: U6.18 (Q1), U17.2 (A1), U18.2 (A1)
DATA_RD2: U6.17 (Q2), U17.3 (A2), U18.3 (A2)
DATA_RD3: U6.16 (Q3), U17.4 (E1), U17.5 (E2), U18.6 (E3)
DATA_WR0: U6.15 (Q4), U19.1 (A0), U20.1 (A0)
DATA_WR1: U6.14 (Q5), U19.2 (A1), U20.2 (A1)
DATA_WR2: U6.13 (Q6), U19.3 (A2), U20.3 (A2)
DATA_WR3: U6.12 (Q7), U19.4 (E1), U19.5 (E2)
FLAG: J6.33, R17.1, U4.4 (A6), U5.4 (A6), U8.4 (A6), U9.4 (A6)
GND: C2.2, C3.2, C4.2, C5.2, C6.2, C7.1, C8.2, C9.2, C10.2, C11.2, C12.2, C13.2, C14.2, C15.1, C16.1, C17.1, C18.1, C19.2, C20.2, C21.2, C22.2, C23.2, C24.2, C25.2, C26.2, D1.2 (A), D3.1 (K), D4.1 (K), J1.5, J1.6, J1.7, J1.8, J2.3, J3.4, J3.5, J3.6, J4.1, J5.4, J5.5, J5.6, J6.1, R2.2, R3.2, R6.1, R10.2, R15.2, R17.2, U1.7 (GND), U2.7 (GND), U3.2 (A), U3.3 (A), U3.6 (A), U3.7 (A), U4.14 (GND), U4.20 (~CE), U4.22 (~OE), U5.14 (GND), U5.20 (~CE), U5.22 (~OE), U6.1 (OE), U6.10 (GND), U7.10 (GND), U8.14 (GND), U8.20 (~CE), U8.22 (~OE), U9.14 (GND), U9.20 (~CE), U9.22 (~OE), U10.1 (E), U10.8 (GND), U11.1 (OE), U11.10 (GND), U12.1 (OE), U12.10 (GND), U13.1, U13.5 (VCC), U14.1, U14.5 (VCC), U15.1 (OE), U15.10 (GND), U16.10 (GND), U17.8 (GND), U18.4 (E1), U18.5 (E2), U18.8 (GND), U19.8 (GND), U20.8 (GND)
IE_DATA: U2.12 (D), U18.12 (O3)
IE_LATCH: U2.11 (C), U20.9 (O6)
INT: J4.17, R15.1, U2.2 (D)
INT_SAMPLE: U2.3 (C), U20.10 (O5)
INT_SYNC: U2.5 (Q), U4.5 (A5), U5.5 (A5), U8.5 (A5), U9.5 (A5)
IR0: U4.27 (A14), U5.27 (A14), U8.27 (A14), U9.27 (A14), U15.12 (Q7)
IR1: U4.2 (A12), U5.2 (A12), U8.2 (A12), U9.2 (A12), U15.13 (Q6)
IR2: U4.26 (A13), U5.26 (A13), U8.26 (A13), U9.26 (A13), U15.14 (Q5)
IR3: U4.3 (A7), U5.3 (A7), U8.3 (A7), U9.3 (A7), U15.15 (Q4)
IR4: U4.25 (A8), U5.25 (A8), U8.25 (A8), U9.25 (A8), U15.16 (Q3)
IR5: U4.24 (A9), U5.24 (A9), U8.24 (A9), U9.24 (A9), U15.17 (Q2)
IR6: U4.23 (A11), U5.23 (A11), U8.23 (A11), U9.23 (A11), U15.18 (Q1)
IR7: U4.21 (A10), U5.21 (A10), U8.21 (A10), U9.21 (A10), U15.19 (Q0)
LATCH_IR: U15.11 (Cp), U20.7 (O7)
unnamed: C1.2, R2.1, SW1.1, U1.11
unnamed: C2.1, C3.1, D1.1 (K), J1.1, J1.2, J1.3, J1.4, Q1.3 (E), Q2.1 (S), R5.2, R7.1
unnamed: C17.2, R13.1, U13.2
unnamed: C18.2, R14.1, U14.2
unnamed: C26.1, D5.2 (A), R16.1, U1.9
unnamed: D2.1 (K), R5.1, R6.2, U3.8 (REF)
unnamed: D2.2 (A), R9.1
unnamed: D3.2 (A), R11.1
unnamed: D4.2 (A), R12.2
unnamed: D5.1 (K), R16.2, U19.9 (O6)
unnamed: Q1.1 (C), Q2.3 (G), R9.2, R10.1, R11.2
unnamed: Q1.2 (B), R8.1
unnamed: R1.2, SW1.2
unnamed: R7.2, R8.2, U3.1 (K)
unnamed: R13.2, U11.14 (Q5)
unnamed: R14.2, U11.15 (Q4)
unnamed: U1.1, U10.11 (O1)
unnamed: U1.3, U10.10 (O2)
unnamed: U1.5, U10.9 (O3)
unnamed: U1.12, U10.15 (E)
unnamed: U2.1 (~R), U2.8 (~Q)
unnamed: U4.11 (D0), U7.14 (D5)
unnamed: U4.12 (D1), U7.13 (D4)
unnamed: U4.13 (D2), U7.8 (D3)
unnamed: U4.15 (D3), U7.7 (D2)
unnamed: U4.16 (D4), U7.17 (D6)
unnamed: U4.17 (D5), U7.18 (D7)
unnamed: U4.18 (D6), U7.4 (D1)
unnamed: U5.11 (D0), U6.7 (D5)
unnamed: U5.12 (D1), U6.8 (D6)
unnamed: U5.13 (D2), U6.9 (D7)
unnamed: U5.15 (D3), U6.6 (D4)
unnamed: U5.16 (D4), U6.5 (D3)
unnamed: U5.17 (D5), U6.4 (D2)
unnamed: U5.18 (D6), U6.3 (D1)
unnamed: U5.19 (D7), U6.2 (D0)
unnamed: U8.19 (D7), U11.2 (D0)
unnamed: U8.18 (D6), U11.3 (D1)
unnamed: U8.17 (D5), U11.4 (D2)
unnamed: U8.16 (D4), U11.5 (D3)
unnamed: U8.15 (D3), U11.6 (D4)
unnamed: U8.11 (D0), U11.7 (D5)
unnamed: U8.12 (D1), U11.8 (D6)
unnamed: U8.13 (D2), U11.9 (D7)
unnamed: U9.19 (D7), U12.2 (D0)
unnamed: U9.18 (D6), U12.3 (D1)
unnamed: U9.17 (D5), U12.4 (D2)
unnamed: U9.16 (D4), U12.5 (D3)
unnamed: U9.15 (D3), U12.6 (D4)
unnamed: U9.11 (D0), U12.7 (D5)
unnamed: U9.12 (D1), U12.8 (D6)
unnamed: U9.13 (D2), U12.9 (D7)
STATE0: U4.10 (A0), U5.10 (A0), U7.19 (Q7), U8.10 (A0), U9.10 (A0)
STATE1: U4.9 (A1), U5.9 (A1), U7.5 (Q1), U8.9 (A1), U9.9 (A1)
STATE2: U4.8 (A2), U5.8 (A2), U7.16 (Q6), U8.8 (A2), U9.8 (A2)
STATE3: U4.7 (A3), U5.7 (A3), U7.6 (Q2), U8.7 (A3), U9.7 (A3)
STATE4: U4.6 (A4), U5.6 (A4), U7.15 (Q5), U8.6 (A4), U9.6 (A4)
STATE5: U5.1 (VPP), U7.9 (Q3), U8.1 (VPP), U9.1 (VPP)
ST_A: J6.16, U20.14 (O1)
ST_ADDR: J4.28, U20.11 (O4)
ST_B: J6.17, U20.13 (O2)
ST_F: J6.18, U20.12 (O3)
WR_A: J6.10, U19.14 (O1)
WR_ADDR_H: J4.10, U20.15 (O0)
WR_ADDR_L: J4.11, U19.7 (O7)
WR_B: J6.11, U19.13 (O2)
WR_C: J6.12, U19.12 (O3)
WR_D: J6.13, U19.11 (O4)
WR_DP: J4.23, U1.6
WR_F: J6.15, U19.10 (O5)
WR_PC: J4.21, U1.2
WR_SP: J4.22, U1.4

Notes on the sheet:
EPROM A
State Counter
IE Latch
INT Latch
EPROM C
Data Bus Controller
EPROM D
Opcodes & Flags Controller
Address Bus Controller
EPROM B
Instruction Register
Bus Driver
Timing Fix
Source & Destination Selectors
Overvoltage Protection
Reset Button & POR
