majsterkowanieinietylko/EPROMINT/(commit log)

2025-07-03 Main ALU files uploaded
    [ALU_board.sch]
2025-07-03 Address board files uploaded
    [Address_board.sch]
2025-07-03 Memory & I/O board files uploaded
    [Mem_IO_board.sch]
2025-07-03 Sequencer board files uploaded
2025-07-03 Display files added
    [7-segment_numeric.sch]
